Virindi-AC/Dollo/modules/geared_z/README.md

Geared Z module. Originally from Dollo.

Moves the bed by a screw mechanism.

Print:
* 1x gear_one (motor drive gear)
* 4x gear_middle
* 4x gear_worm
* 4x stabilizer
* 4x twist_corner_120 or 8x twist_corner_60
* 4x twist_corner_riser
