Virindi-AC/Dollo/modules/geared_z_spegelius/README.md

Geared Z module. Originally from Spegelius/Dollo.

Moves the bed by a screw mechanism. Similar to original version but with finer gear pitch.

Print:
* 1x gear_one (motor drive gear)
* 4x gear_middle
* 4x gear_worm
* 4x stabilizer
* 4x twist_corner_120 or 8x twist_corner_60
* 4x twist_corner_riser
