Virindi-AC/Dollo/modules/endstops/README.md

Endstop mounting module. Originally from Dollo.
