Virindi-AC/Dollo/modules/spegelius_rack_and_pinion/README.md

Rack and pinion module. Originally from Spegelius/Dollo.

Uses Snappy-derived gear. Motor mount modified to ride on both top and bottom face.
