Virindi-AC/Dollo/modules/virindi_rack_and_pinion/README.md

Rack and pinion module.

Derived from Dollo rack and pinion. Modified for motor set screws.
