Virindi-AC/Dollo/modules/head_e3d/README.md

The original Dollo hotend mount. Contains a single E3Dv6 clone.
