Virindi-AC/Dollo/modules/head_e3d_sensor_fan/README.md

A head that contains an E3Dv6 clone, an 18mm proximity sensor, and a fan. Requires cut out X spacers.
