Virindi-AC/Dollo/include/snappy-reprap/STLs/drive_gear_parts.stl

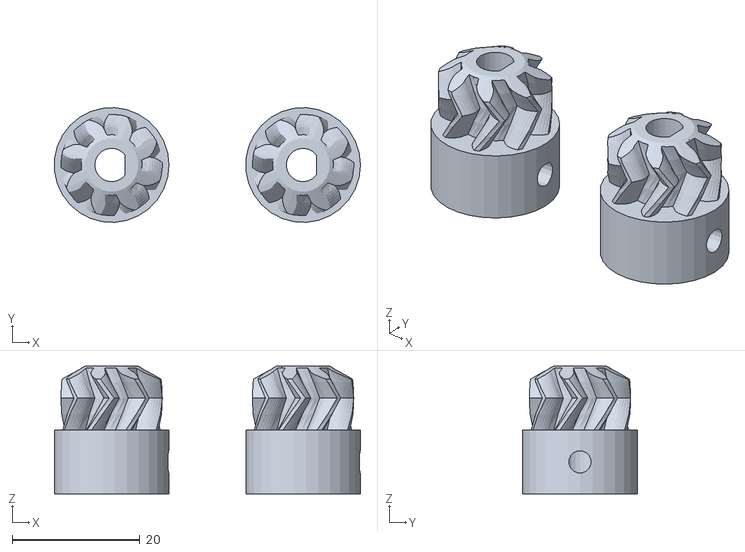
[picture p1: CAD file, 2016-12-03]
include/snappy-reprap/STLs/drive_gear_parts.stl
47.9 x 18.0 x 20.0
