Virindi-AC/Dollo/modules/virindi_rack_and_pinion/small_gear.dxf

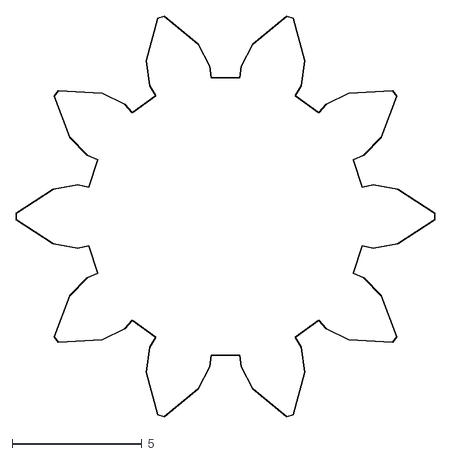
[picture p2: CAD file, 2016-12-03]
modules/virindi_rack_and_pinion/small_gear.dxf
16.2 x 15.5
