Virindi-AC/Dollo/include/snappy-reprap/STLs/ramps_mount_parts.stl

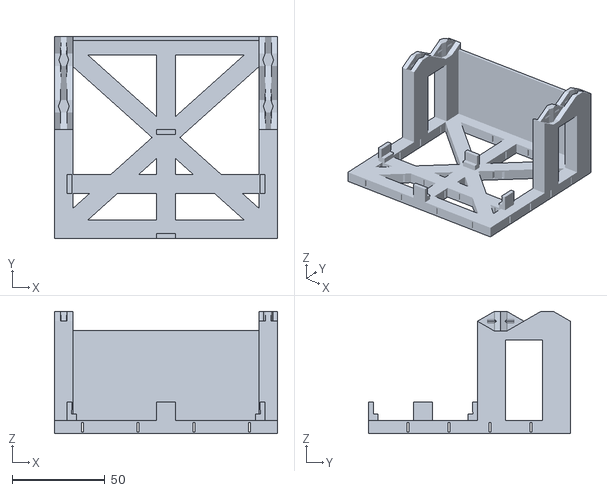
[picture p3: CAD file, 2016-12-03]
include/snappy-reprap/STLs/ramps_mount_parts.stl
120.0 x 108.5 x 65.8
