Virindi-AC/Dollo/modules/virindi_rack_and_pinion/rack.dxf

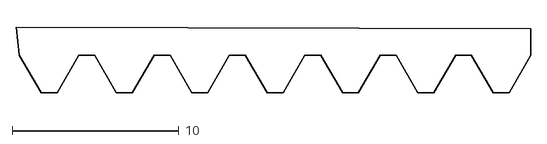
[picture p4: CAD file, 2016-12-03]
modules/virindi_rack_and_pinion/rack.dxf
30.8 x 3.95
