Virindi-AC/Dollo/include/snappy-reprap/STLs/rail_z_endcap_parts.stl

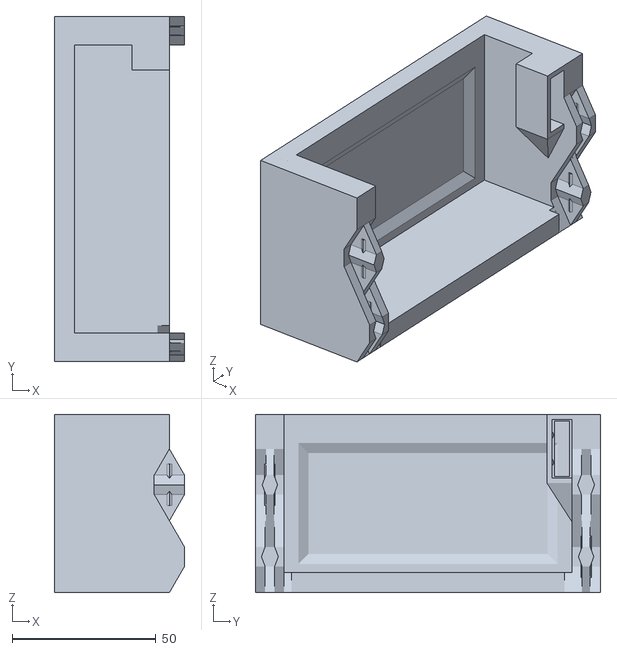
[picture p5: CAD file, 2016-12-03]
include/snappy-reprap/STLs/rail_z_endcap_parts.stl
45.3 x 120.0 x 62.0
