Virindi-AC/Dollo/include/snappy-reprap/STLs/extruder_motor_clip_parts.stl

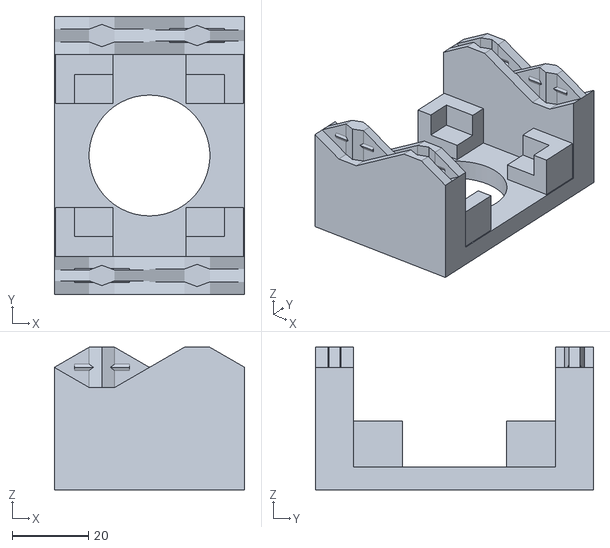
[picture p6: CAD file, 2016-12-03]
include/snappy-reprap/STLs/extruder_motor_clip_parts.stl
50.0 x 73.0 x 37.4
