Virindi-AC/Dollo/include/snappy-reprap/STLs/platform_support_parts.stl

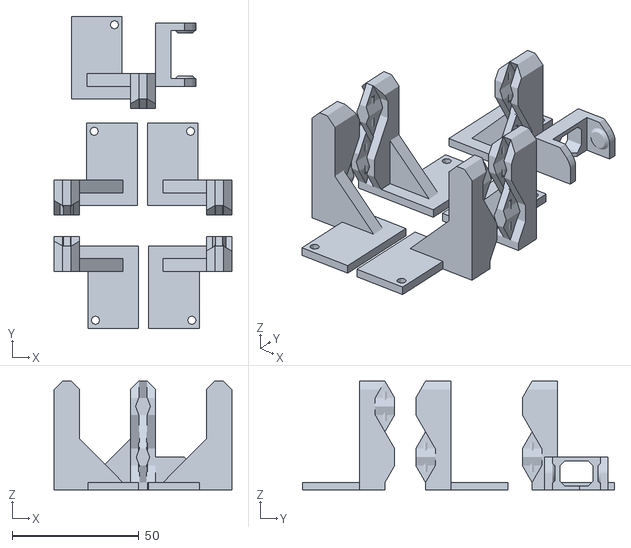
[picture p7: CAD file, 2016-12-03]
include/snappy-reprap/STLs/platform_support_parts.stl
70.0 x 123.0 x 43.0
