Virindi-AC/Dollo/include/snappy-reprap/STLs/xy_joiner_parts.stl

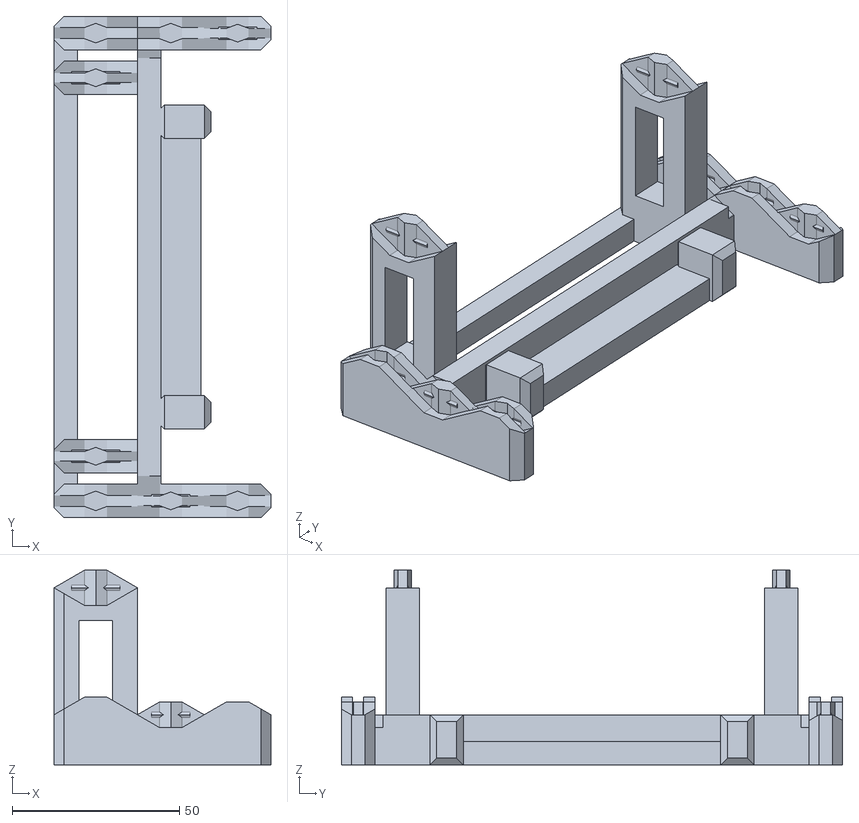
[picture p8: CAD file, 2016-12-03]
include/snappy-reprap/STLs/xy_joiner_parts.stl
65.0 x 150.0 x 58.3
