Virindi-AC/Dollo/include/snappy-reprap/STLs/extruder_idler_parts.stl

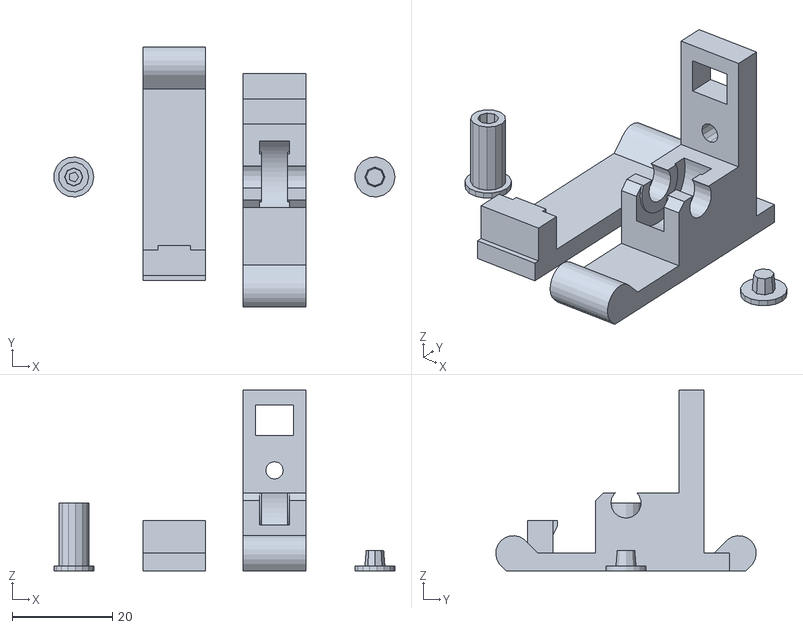
[picture p9: CAD file, 2016-12-03]
include/snappy-reprap/STLs/extruder_idler_parts.stl
67.9 x 51.9 x 36.0
