Virindi-AC/Dollo/include/snappy-reprap/STLs/sled_endcap_parts.stl

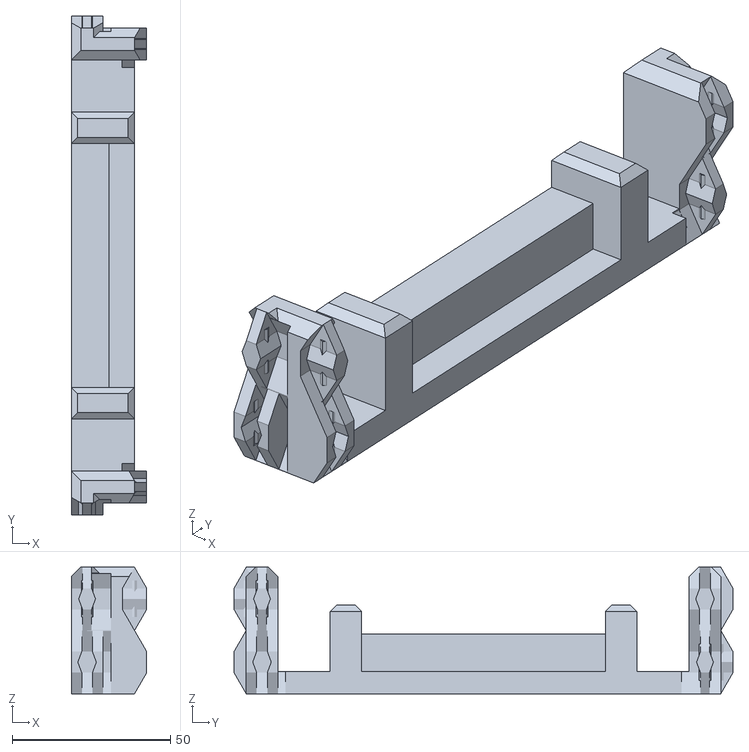
[picture p10: CAD file, 2016-12-03]
include/snappy-reprap/STLs/sled_endcap_parts.stl
23.8 x 157.7 x 40.0
