Virindi-AC/Dollo/include/snappy-reprap/STLs/cable_chain_link_parts.stl

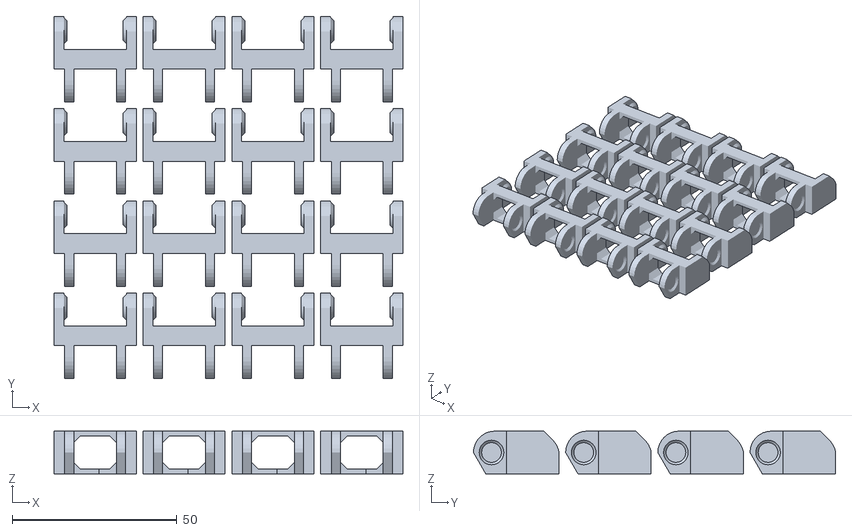
[picture p11: CAD file, 2016-12-03]
include/snappy-reprap/STLs/cable_chain_link_parts.stl
106.0 x 110.0 x 13.0
