Virindi-AC/Dollo/include/snappy-reprap/STLs/lifter_rod_coupler_parts.stl

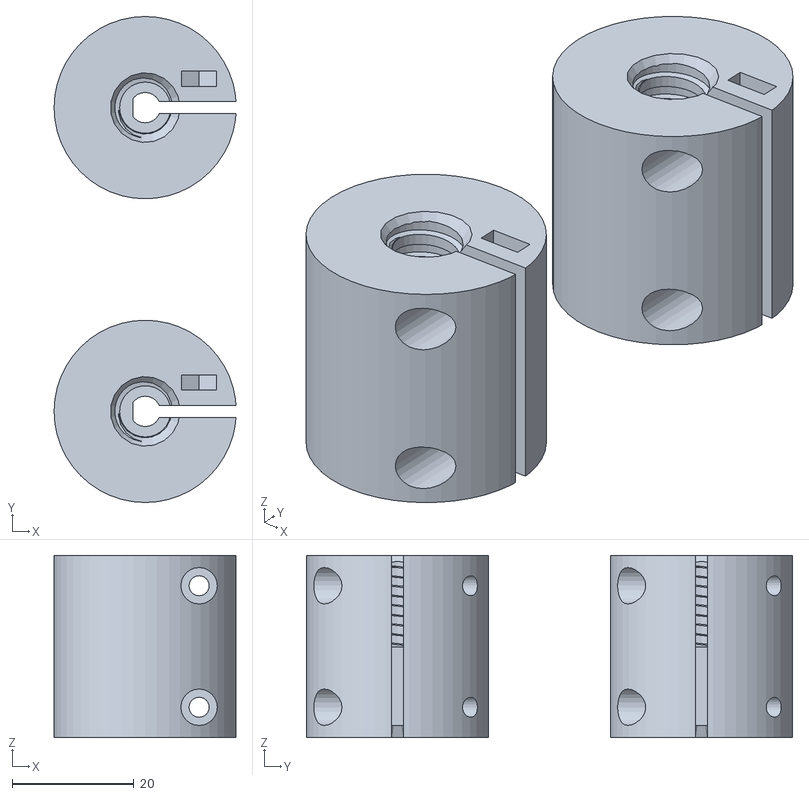
[picture p12: CAD file, 2016-12-03]
include/snappy-reprap/STLs/lifter_rod_coupler_parts.stl
29.9 x 80.0 x 30.0
