Virindi-AC/Dollo/include/snappy-reprap/STLs/spool_holder_parts.stl

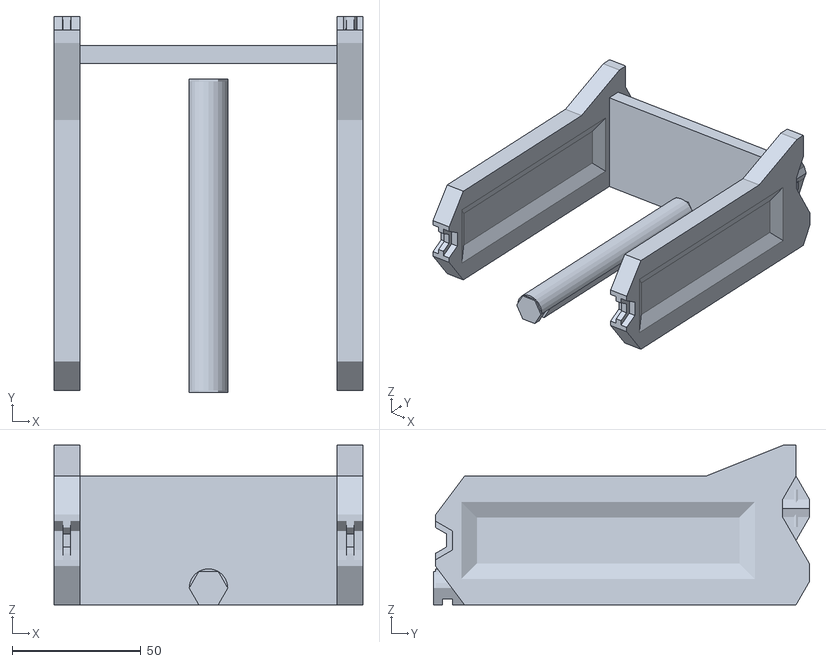
[picture p13: CAD file, 2016-12-03]
include/snappy-reprap/STLs/spool_holder_parts.stl
120.0 x 146.2 x 62.0
