Virindi-AC/Dollo/include/snappy-reprap/STLs/slop_calibrator_parts.stl

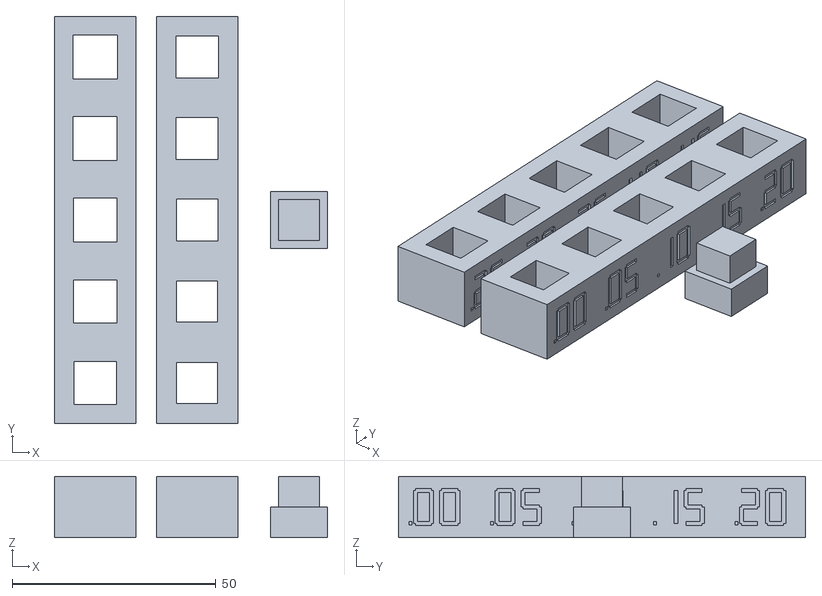
[picture p14: CAD file, 2016-12-03]
include/snappy-reprap/STLs/slop_calibrator_parts.stl
67.0 x 100.0 x 15.0
