Virindi-AC/Dollo/include/snappy-reprap/STLs/cooling_fan_shroud_parts.stl

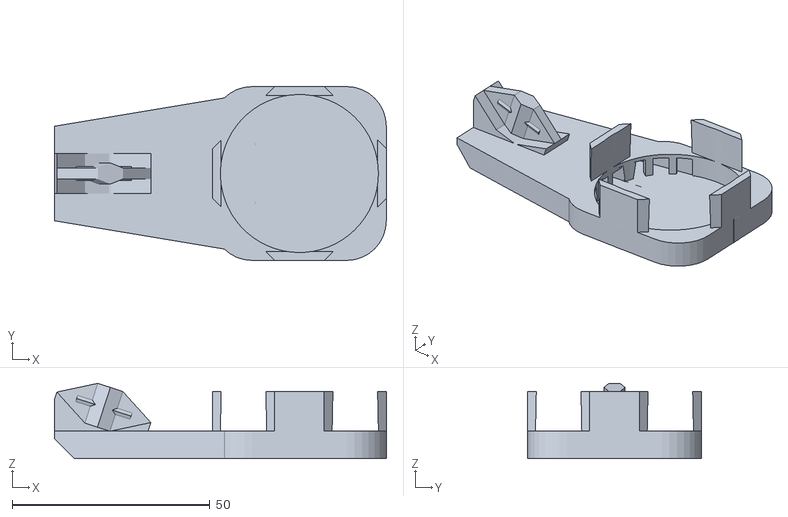
[picture p15: CAD file, 2016-12-03]
include/snappy-reprap/STLs/cooling_fan_shroud_parts.stl
84.0 x 44.1 x 19.1
