Virindi-AC/Dollo/include/snappy-reprap/STLs/jhead_platform_parts.stl

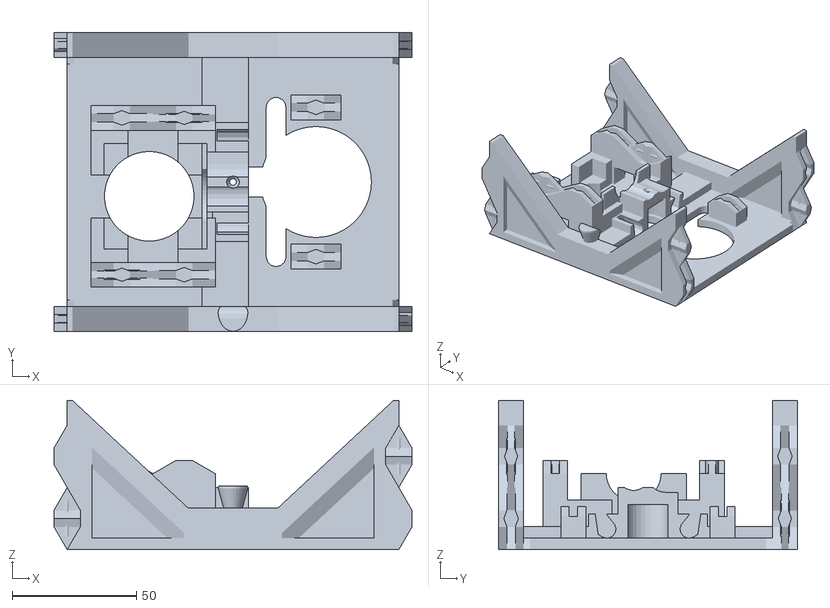
[picture p16: CAD file, 2016-12-03]
include/snappy-reprap/STLs/jhead_platform_parts.stl
143.8 x 120.0 x 60.0
