Virindi-AC/Dollo/include/snappy-reprap/STLs/rail_z_motor_segment_parts.stl

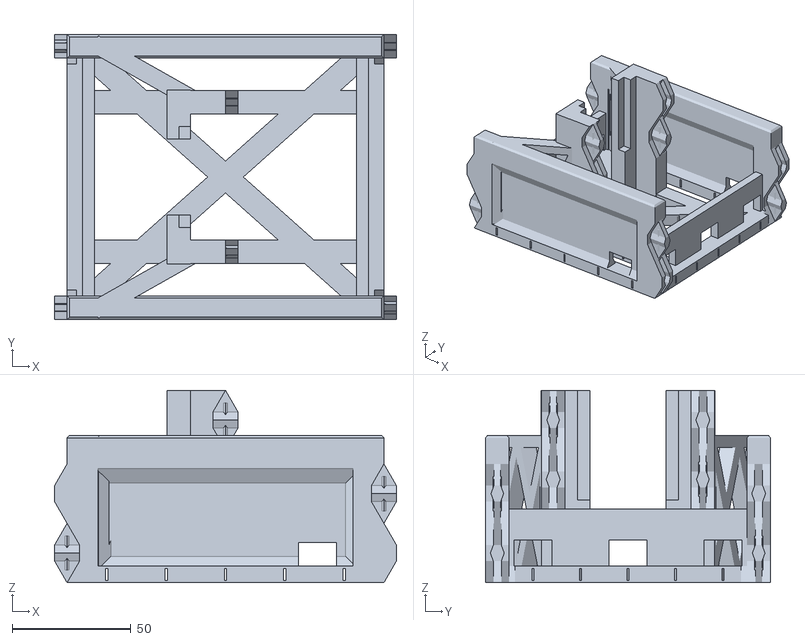
[picture p18: CAD file, 2016-12-03]
include/snappy-reprap/STLs/rail_z_motor_segment_parts.stl
143.9 x 120.0 x 81.0
