Virindi-AC/Dollo/include/snappy-reprap/STLs/extruder_fan_shroud_parts.stl

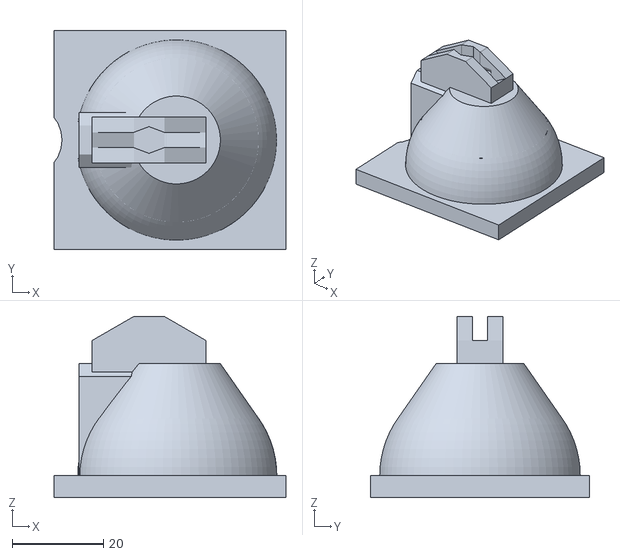
[picture p19: CAD file, 2016-12-03]
include/snappy-reprap/STLs/extruder_fan_shroud_parts.stl
50.8 x 48.0 x 39.7
