Virindi-AC/Dollo/include/snappy-reprap/STLs/rail_xy_motor_segment_parts.stl

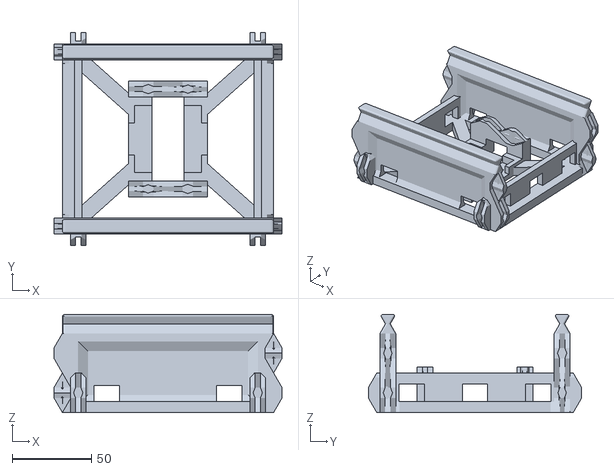
[picture p20: CAD file, 2016-12-03]
include/snappy-reprap/STLs/rail_xy_motor_segment_parts.stl
143.9 x 134.6 x 62.0
