Virindi-AC/Dollo/include/snappy-reprap/STLs/yz_joiner_parts.stl

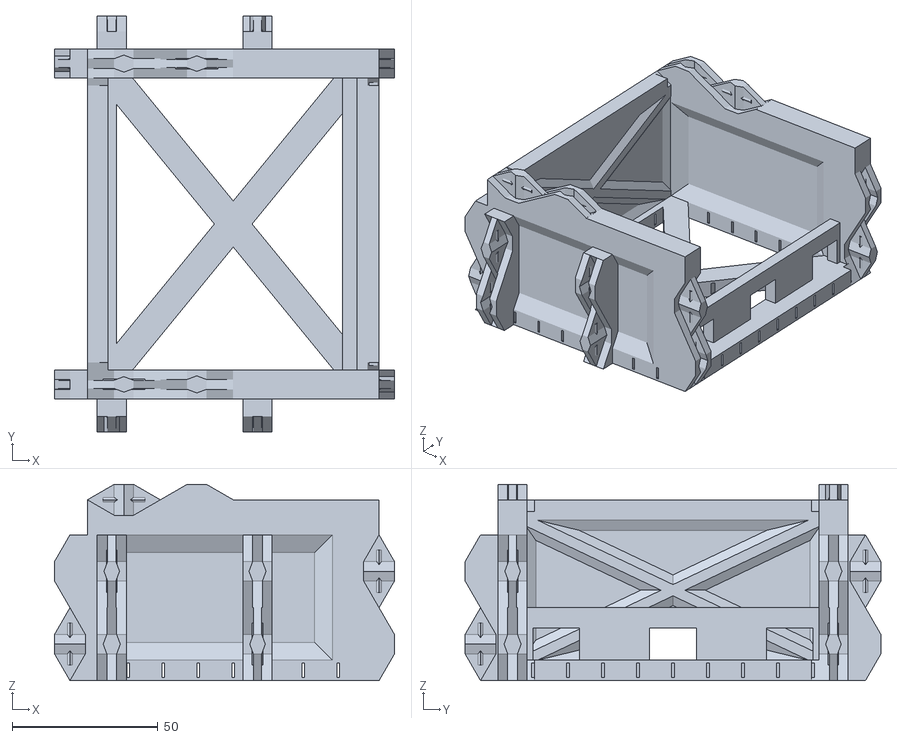
[picture p21: CAD file, 2016-12-03]
include/snappy-reprap/STLs/yz_joiner_parts.stl
116.6 x 142.6 x 67.3
