Virindi-AC/Dollo/include/snappy-reprap/STLs/xy_sled_parts.stl

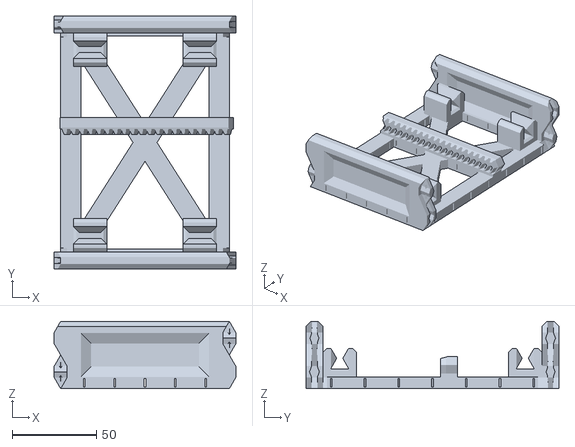
[picture p22: CAD file, 2016-12-03]
include/snappy-reprap/STLs/xy_sled_parts.stl
107.7 x 150.0 x 40.0
