Virindi-AC/Dollo/include/snappy-reprap/STLs/rambo_mount_parts.stl

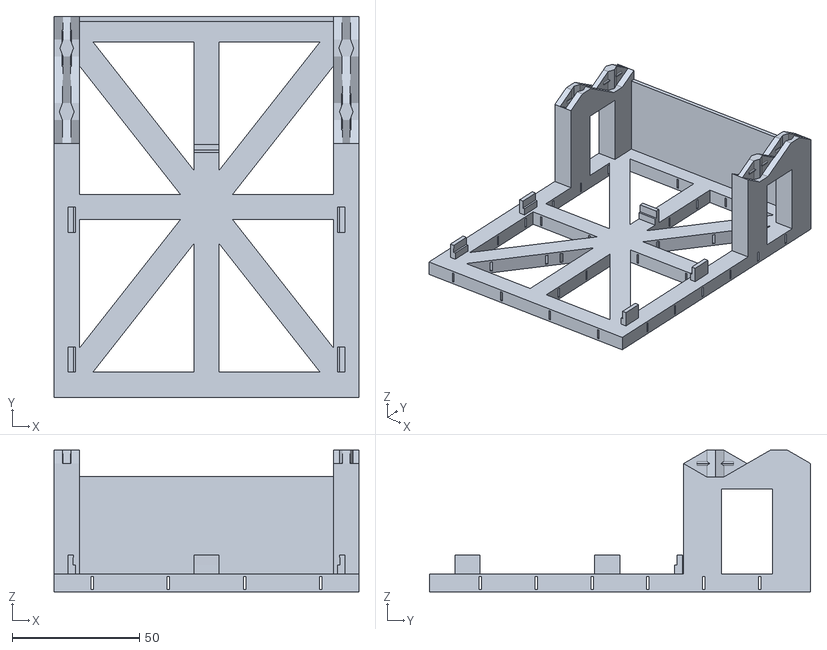
[picture p23: CAD file, 2016-12-03]
include/snappy-reprap/STLs/rambo_mount_parts.stl
120.0 x 150.0 x 55.8
