Virindi-AC/Dollo/include/snappy-reprap/STLs/cable_chain_mount_parts.stl

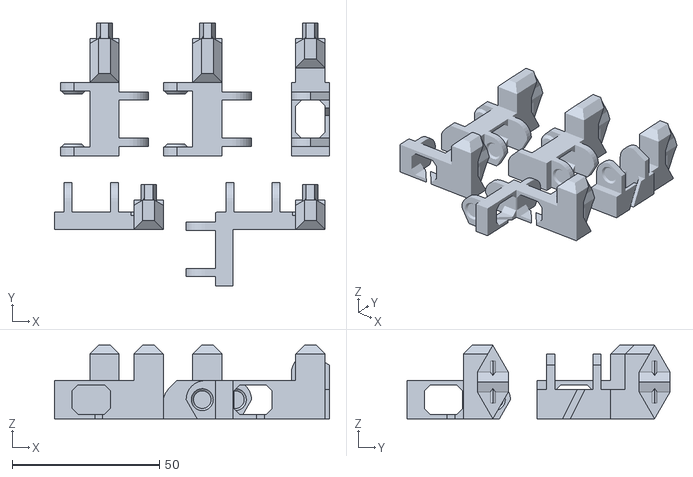
[picture p24: CAD file, 2016-12-03]
include/snappy-reprap/STLs/cable_chain_mount_parts.stl
93.5 x 89.5 x 25.0
