Virindi-AC/Dollo/include/snappy-reprap/STLs/z_sled_parts.stl

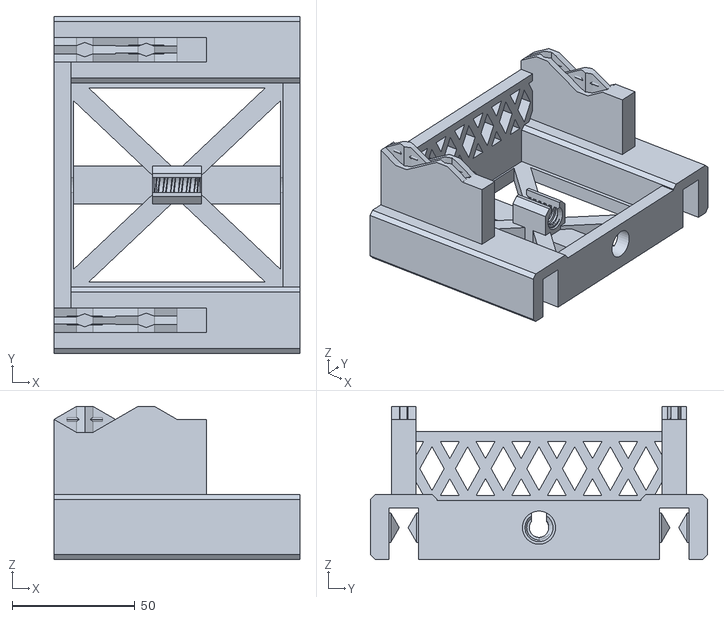
[picture p25: CAD file, 2016-12-03]
include/snappy-reprap/STLs/z_sled_parts.stl
100.0 x 137.0 x 62.3
