Virindi-AC/Dollo/include/snappy-reprap/STLs/extruder_fan_clip_parts.stl

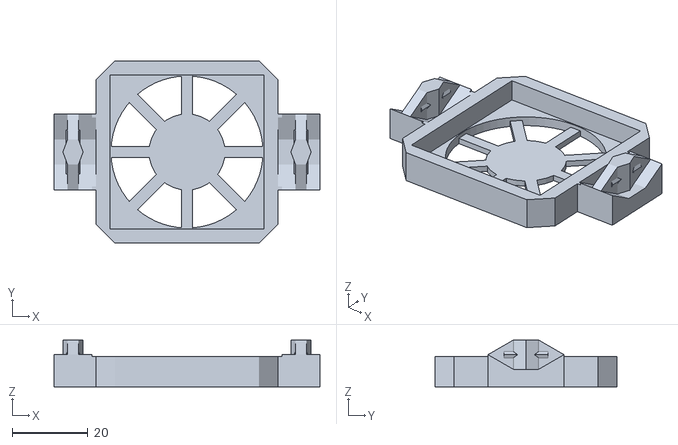
[picture p26: CAD file, 2016-12-03]
include/snappy-reprap/STLs/extruder_fan_clip_parts.stl
70.0 x 48.0 x 12.3
