Virindi-AC/Dollo/include/snappy-reprap/STLs/motor_mount_plate_parts.stl

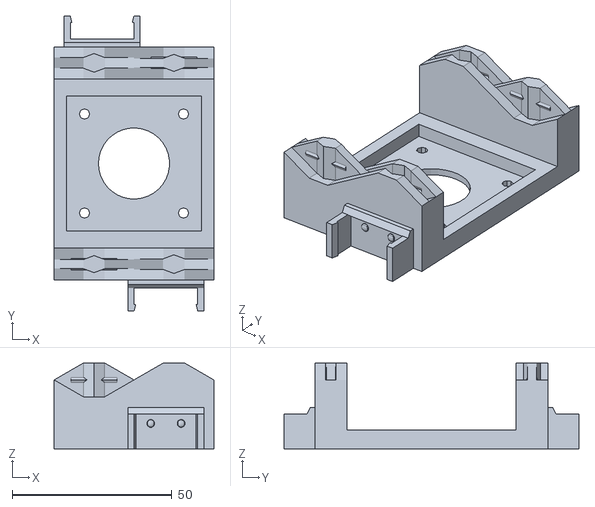
[picture p27: CAD file, 2016-12-03]
include/snappy-reprap/STLs/motor_mount_plate_parts.stl
50.0 x 92.3 x 26.9
