Virindi-AC/Dollo/include/snappy-reprap/STLs/support_leg_parts.stl

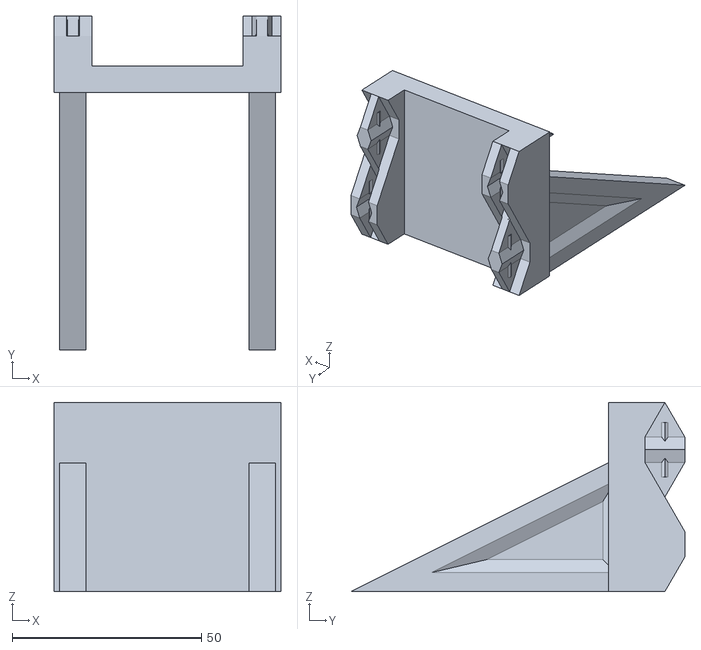
[picture p28: CAD file, 2016-12-03]
include/snappy-reprap/STLs/support_leg_parts.stl
60.0 x 88.2 x 50.0
