Virindi-AC/Dollo/include/conf/sturdy_E3D_config.scad

//
// Mendel90
//
// GNU GPL v2
// nop.head@gmail.com
// hydraraptor.blogspot.com
//
// Configuration file
//
echo("Sturdy E3D:");

Z_bearings = LM6UU;
Y_bearings = LM6UU;
X_bearings = LM6UU;

X_motor = NEMA17;
Y_motor = NEMA17;
Z_motor = NEMA17;

hot_end = e3dv6;

X_travel = 110;
Y_travel = 82;
Z_travel = 169;

bed_depth = 82;
bed_width = 110;
bed_pillars = M3x20_pillar;
bed_glass = glass2;
bed_thickness = pcb_thickness + sheet_thickness(bed_glass);    // PCB heater plus glass sheet
bed_holes = [209, 209];

base = MDF19;
base_corners = 0;

frame = MDF19;
frame_corners = 0;
frame_nuts = false;

case_fan = fan80x38;
psu = ALPINE500;
//psu = KY240W;
controller = Melzi;
//controller = Sanguinololu;
spool = spool_300x85;
bottom_limit_switch = false;
top_limit_switch = true;

single_piece_frame = true;
stays_from_window = false;

Y_carriage = DiBond;

pulley_type = GT2x20_metal_pulley;
X_belt = GT2x6;
Y_belt = GT2x6;

motor_shaft = 5;
Z_screw_dia = 12.7;            // Studding for Z axis

Y_carriage_depth = bed_holes[1] + 8;
Y_carriage_width = bed_holes[0] + 8;

Z_nut_radius = 11.2;
Z_nut_depth = 44.5;//11.25;
Z_nut = M8_nut;

//
// Default screw use where size doesn't matter
//
cap_screw = M3_cap_screw;
hex_screw = M3_hex_screw;
//
// Screw for the frame and base
//
frame_soft_screw = No6_screw;               // Used when sheet material is soft, e.g. wood
frame_thin_screw = M3_cap_screw;            // Used with nuts when sheets are thin
frame_thick_screw = M3_pan_screw;           // Used with tapped holes when sheets are thick and hard, e.g. plastic or metal
//
// Feature sizes
//
default_wall = 4;
thick_wall = 4;
