Virindi-AC/Dollo/include/conf/machine.scad

include <sturdy_E3D_config.scad>
