Virindi-AC/Dollo/modules/head_e3d_sensor_fan/x_spacer_cut.scad

include <../../globals.scad>;
include <../../include.scad>;
use <long_bow_tie_cut.scad>

tail_depth = 55;
tail_depth_2 = -10;
thickness = 21;
module y_mount_added(){
	translate([0,-15+6-3.5,51/2]) cube([30,thickness,51], center=true);
    
    translate([-8,-12.5+thickness/2,-55+tail_depth]) scale([dovetail_male_width_scale, dovetail_male_height_scale, 0.9]) male_dovetail(height=15);
	translate([8,-12.5+thickness/2,-55+tail_depth]) scale([dovetail_male_width_scale, dovetail_male_height_scale, 0.9]) male_dovetail(height=15);
    

}

module y_mount_taken(){
	translate([0,-thickness/2-12.5,15]) rotate([0,45,0]) tie_end();
    
	rotate([180,0,0]) translate([-8,12.5-thickness/2,-55+tail_depth_2]) scale([.9,.9,.9]) male_dovetail(height=30);
	rotate([180,0,0]) translate([8,12.5-thickness/2,-55+tail_depth_2]) scale([.9,.9,.9]) male_dovetail(height=30);
translate([-15,-45,0]) wrap(3);
}
/*
rotate([90,0,0]) difference(){
	translate([0,-thickness/2-12.5,15]) bow_support();
	translate([0,-thickness/2-12.5,25]) cube([50,10,20], center=true);
	translate([0,-thickness/2-12.5,0]) cube([31,10,20], center=true);
}
*/

module x_spacer()
{
rotate([90,0,0]) 
    difference(){
	y_mount_added();
	y_mount_taken();
        
    translate([0,0,240-4])
    rotate([0,-40,0])
    cube([300,300,300],center=true);
    
    translate([0,0,150+47])
    cube([300,300,300],center=true);
}
}



translate([20,0,0])
x_spacer();

translate([-20,0,0])
mirror([1,0,0]) x_spacer();

//translate([-28,-38,0])
//cut_tie();
