Virindi-AC/Dollo/modules/printed_bed_base/arm.scad

use <bed_carriage.scad>

height = 12;
translate([-50,-50]) arm();
