Virindi-AC/Dollo/modules/printed_bed_base/center_motor.scad

use <bed_carriage.scad>

height = 12;
translate([0,0,0]) center_motor();
