Virindi-AC/Dollo/modules/printed_bed_base/corner_arm.scad

use <bed_carriage.scad>

height = 12;
translate([-60,-70]) rotate([0,0,315]) corner_arm();
