Virindi-AC/Dollo/modules/printed_bed_base/edge_arm_left.scad

use <bed_carriage.scad>

height = 12;
translate([60,10, height]) rotate([0,180,90]) edge_arm();
