Virindi-AC/Dollo/modules/printed_bed_base/edge_arm_right.scad

use <bed_carriage.scad>

height = 12;
translate([60,-205, height]) mirror([0,1,0]) rotate([0,180,90]) edge_arm();
