Virindi-AC/Dollo/modules/printed_bed_base/motor_arm.scad

use <bed_carriage.scad>

height = 12;
translate([-40,-120,0]) motor_arm();
