Virindi-AC/Dollo/modules/printed_structural/long_bow_tie_motorspacer.scad

length = 15.5;
tilt_level = 1.1;
scaling_x = .95;
scaling_y = 1;
scaling_z = 1;
include <../../include.scad>;
include <../../globals.scad>;

obj_leg= 12;
module bow_tie_master(){
	union(){
		mirror([0,1,0]){
			scale([1.08,1,1]) male_dovetail(height=length);
		}
			male_dovetail(height=length);		
	}
}

intersection(){
    scale([scaling_x,scaling_y,scaling_z])	rotate([90,0,0]) bow_tie_master();
    rotate([90,0,0]) cylinder(r=5.7, h=200);
}
