Virindi-AC/Dollo/modules/geared_z_spegelius/gear_middle.scad

use <gears.scad>

middle_gear();
