Virindi-AC/Dollo/modules/geared_z_spegelius/gear_one.scad

use <gears.scad>

gear_one();
