Virindi-AC/Dollo/modules/geared_z_spegelius/gear_worm.scad

use <gears.scad>

gear_large();
