Virindi-AC/Dollo/modules/geared_z_spegelius/twist_corner.scad

include <../../include.scad>;
include <../../globals.scad>;
use <gears.scad>;

///////////////////// FOCUS ON THIS NOW //////////////////////////////
tooth_depth = (sqrt(18)/2)+2;
twisted_depth = 2;
//units = 4; //Multiple of 2
r =37;
mirror = true;
double = false; //this will make the piece twist in both directions. only works if you have a high pitch screw

gearOne = -16.5;
gear_reverse = -10;
gearLarge = -32.6+(gearOne/2);

resolution = 60;
///////////////////// FOCUS ON THIS NOW //////////////////////////////

// side rounded hollows and inside dovetail tracks
module wrap(units){
    translate([-16.5,30+4,-32]) rotate([0,90,-90]) male_dovetail();
    translate([-32,30+4,-16.5]) rotate([-90,180,0])  male_dovetail();
    
    rotate([90,0,0]) translate([-35,-1,-25*units]) cylinder(h=35*units, r=8);
    mirror([1,0,-1]) rotate([90,0,0]) translate([-35,-1,-25*units]) cylinder(h=35*units, r=8);
}

module arm_movement(units){
	difference(){
		//part im trying to make
        difference(){
            translate([-95+tooth_depth,-95+tooth_depth,15*units]) rotate([0,0,45]) cube([45,45,((units+1)*30)-.25], center=true);
            translate([-105+(-15/2),-105+(-15/2),30]) cube([45,45,30*2*units], center=true);
        }
        //twist
	
        for (extrude=[0:units+3]){
            translate([0+(gearLarge+(gearLarge/2))+tooth_depth,0+(gearLarge+(gearLarge/2))+tooth_depth,extrude*20]) color([0,1,0]) rotate([0,0,(360/22)*1.75]) twist_large_extrude($fn=resolution);
            translate([21.5-95,21.5-95,extrude*30-45-5]) rotate([90,0,90]) wrap(units=units);
        }

	}
}

module finished(units){
	intersection(){
		translate([95,95,0]) arm_movement(units=units);
		hull(){
			translate([tooth_depth+25.5,0,0]) cylinder(h=(units+2)*30, r=2);
			translate([0,tooth_depth+25.5,0]) cylinder(h=(units+2)*30, r=2);
			
			translate([-(tooth_depth+26),1,0]) cylinder(h=(units+2)*30, r=2);
			translate([1,-(tooth_depth+26),0]) cylinder(h=(units+2)*30, r=2);
		}
	}
}
module base(units){
	intersection(){
		translate([0,0,0]) rotate([0,0,45]) finished(units=units);
		//translate([-50,-50,0]) cube([100,100,units*40]);
	}
}

module top_dove(units) {
    intersection() {
        scale([dovetail_male_width_scale, 1, dovetail_male_height_scale]) rotate ([90,0,0]) intersection() {
            intersection() {
                male_dovetail(height=11.7);
                translate([-6,0,0]) cube([10,4.6,25]);
            }
            translate([0,-0.3, 0]) cylinder(r=5.7, h=20);
        }
        translate([-5,-6,-4.2]) rotate([0,90,0]) cylinder(r=10, h=20);
    }
}
//translate([50,50,0]) top_dove(); //testing

module twist_corner(units = 4){
    difference(){
        intersection(){
            rotate([0,-2,0]) base(units=units);
            translate([-50,-50,1.38]) cube([100,100,units*30]);
        }
        translate([0,0,1]) union(){
            translate([11,15,0]) rotate([90,0,0]) male_dovetail(height=25);
            translate([-11,15,0]) rotate([90,0,0]) male_dovetail(height=25);
        }
    }

    translate([-2 * (units/2),0,0]) difference(){
        union(){
            translate([11,14.2,30*units+1.1]) top_dove(units=units);
            translate([-11,14.2,30*units+1.1]) top_dove(units=units);
        }
            translate([0,-33,0]) rotate([0,0,45]) cube([30,30,units*45]);
        }
}

// do it
//twist_corner(units = );
