Virindi-AC/Dollo/modules/geared_z_spegelius/twist_corner_120.scad

use <twist_corner.scad>

twist_corner(units = 4);
