Virindi-AC/Dollo/modules/geared_z_spegelius/twist_corner_60.scad

use <twist_corner.scad>

twist_corner(units = 2);
