Virindi-AC/Dollo/modules/printed_bed_base/boltholder.scad

use <bed_carriage.scad>

height = 12;
translate([70, -100]) boltholder();
