Virindi-AC/Dollo/modules/printed_bed_base/boltholder_center.scad

use <bed_carriage.scad>

height = 12;
translate([90, -100]) boltholder_center();
