Virindi-AC/Dollo/modules/printed_bed_base/center.scad

use <bed_carriage.scad>

height = 12;
center();
