Virindi-AC/Dollo/modules/printed_structural/bow_tie.scad

smoothing = 100;
length = 13;
tilt_level = 1.1;
scaling_x = .9;
scaling_y = 1;
scaling_z = 1;
include <../../include.scad>;
include <../../globals.scad>;

obj_leg= 12;
$fn = smoothing;
module bow_tie_master(){
	union(){
		mirror([0,1,0]) 		intersection(){
			intersection(){
				rotate([0,-45,0]) cube([obj_leg,obj_leg,obj_leg]);
				translate([-obj_leg/2,(obj_leg/2)-tilt_level,-5]) rotate([45,0,0]) cube([obj_leg,obj_leg,obj_leg*2]);
				#translate([0,length/4,length*.5]) rotate([45,0,0]) sphere(d=length*tilt_level);
			}
			male_dovetail(height=length);
		}
		
		intersection(){
			intersection(){
				rotate([0,-45,0]) cube([obj_leg,obj_leg,obj_leg]);
				translate([-obj_leg/2,(obj_leg/2)-tilt_level,-5]) rotate([45,0,0]) cube([obj_leg,obj_leg,obj_leg*2]);
				#translate([0,length/4,length*.5]) rotate([45,0,0]) sphere(d=length*tilt_level);
			}
			male_dovetail(height=length);
		}
		
	}
}
module bow_holes() {
	//translate([-10,-2.5,-2.5]) rotate([0,90,0]) #cylinder(h=50, d=1.5);
	//translate([-10,2.5,-2.5]) rotate([0,90,0]) #cylinder(h=50, d=1.5);
}

module finished(){
	rotate([0,45*0,0]){
		difference(){
			rotate([0,180,0]) bow_tie_master();
			bow_holes();
            translate([0,0,-25]) cylinder(d=2.5, h=50);
		}
	}
}

scale([scaling_x,scaling_y,scaling_z]) finished();
