Virindi-AC/Dollo/modules/printed_structural/extension_120.scad

use <extension.scad>

extension_finished(units=4);
