Virindi-AC/Dollo/modules/printed_structural/extension_120_side.scad

use <extension.scad>

rotate([-90,0,0])
extension_finished(units=4,support=false);
