Virindi-AC/Dollo/modules/printed_structural/extension_30.scad

use <extension.scad>

extension_finished(units=1);
