Virindi-AC/Dollo/modules/v4x/extension_10.scad

use <../printed_structural/extension.scad>

extension_finished(units=(10-0.9)/30, support=false);
