Virindi-AC/Dollo/modules/v4x/extension_250.scad

use <../printed_structural/extension.scad>

extension_finished(units=250/30, support=true);
