Virindi-AC/Dollo/modules/virindi_rack_and_pinion/rack.scad

include <../../include.scad>;
include <../../globals.scad>;


//globals

obj_height = 40;
//units = 10; //only even numbers
tail_depth = 8;
tie_scale_x = 1;
tie_scale_y = 1;
tie_scale_z = 1;
gear_cut_depth = 4;
gear_cut_from_center = 9.25;
rounding_diameter = 4;

resolution = 10;

//good things
module rounded_cube(width,depth,height){
    hull(){
        translate([width/2-rounding_diameter/2,depth/2-rounding_diameter/2,height/2-rounding_diameter/2]) sphere(d=rounding_diameter);
        translate([width/2-(rounding_diameter/2),depth/2-(rounding_diameter/2),-height/2+(rounding_diameter/2)]) sphere(d=rounding_diameter);
        translate([-width/2+rounding_diameter/2,depth/2-rounding_diameter/2,height/2-rounding_diameter/2]) sphere(d=rounding_diameter);
        translate([-width/2+(rounding_diameter/2),depth/2-(rounding_diameter/2),-height/2+(rounding_diameter/2)]) sphere(d=rounding_diameter);
        
        translate([width/2-rounding_diameter/2,-depth/2+rounding_diameter/2,height/2-rounding_diameter/2]) sphere(d=rounding_diameter);
        translate([width/2-(rounding_diameter/2),-depth/2+(rounding_diameter/2),-height/2+(rounding_diameter/2)]) sphere(d=rounding_diameter);
        translate([-width/2+rounding_diameter/2,-depth/2+rounding_diameter/2,height/2-rounding_diameter/2]) sphere(d=rounding_diameter);
        translate([-width/2+(rounding_diameter/2),-depth/2+(rounding_diameter/2),-height/2+(rounding_diameter/2)]) sphere(d=rounding_diameter);
    }
}  

module tie_taken(){
		difference(){
			translate([0,tail_depth,0]) rotate([0,90,180]) scale([tie_scale_x,tie_scale_z,tie_scale_y])  male_dovetail(height=30);
		}
}


//herring bone style rack made from inkscape and OpenScad
module rackObject(units=10) {

    module rackHalf(){
        intersection() {
            union() {
                rotate(a=[0,-25,0]) {
                    linear_extrude(height = obj_height*5, center = true, convexity = 10)
                    import (file = "rack.dxf", layer = "Layer_1");
                }
            }
			translate([0, 0, obj_height/4*-1]) cube(center = true, [31, 50, obj_height/2]);
        }
    }
    module rackFull(){
        intersection() {
            union() {
                mirror([0,0,1]) rackHalf();
                rackHalf();
            }
            union() {
                cube(center = true, [20, 30, obj_height-8]);

            }
        }
    }

    for(rack_length=[-units:5]){
        translate([rack_length*20,0,0]) {
					intersection(){
						rackFull();
						scale([1,.25,1]) translate([0,5,0]) rotate([0,90,0]) cylinder(r=15, h=40, center=true);
					}
		}
	}

	for(rack_length=[-units:1]){
		difference(){
			translate([30*rack_length+15,6,0]) cube([30,8,40], center=true);
		}
	}
}

module rack(units=10)
{
    difference(){
    intersection(){
    //translate([0,0,-10]) cube([20,20,20]);
        intersection(){
            rotate([-90,0,0]) translate([-10-((units-2)*15),0,0]) translate([30,0,0]) rounded_cube(30*units+10,20,40,$fn=resolution);
            union(){
                rotate([-90,0,0]) intersection(){
                    difference(){
                        rackObject();
                        for(rack_length=[-units:1]){
                            translate([30*rack_length+30,2,0]) tie_taken();
                        }
                    }

                    difference(){
                        union(){
                            translate([30,0,0]) rounded_cube(30*units,20,40,$fn=50);
                            translate([-12.5-((units-2)*15),-5,0]) rotate([0,25,0]) cube([30,30,30]);
                            mirror([0,0,1]) translate([-12.5-((units-2)*15),-5,0]) rotate([0,25,0]) cube([30,30,30]);
                        }
                        union(){
                            translate([47.5,-5,0]) rotate([0,25,0]) cube([units*30,30,units*30]);
                            mirror([0,0,1]) translate([47.5,-5,0]) rotate([0,25,0]) cube([units*30,30,units*30]);
                        }
                    }
                //intersection
                }
            //union
            }
        //intersection
        }
    //intersection
    }

    translate([0,10+gear_cut_from_center,25-gear_cut_depth])
    cube([30*units+1,20,50],center=true);
    }
}

rack();
