Virindi-AC/Dollo/modules/virindi_rack_and_pinion/rack_x.scad

use <rack.scad>

rack(units=8);
