Virindi-AC/Dollo/(list of files, cad)

Other CAD files:
include/snappy-reprap/STLs/rail_segment_parts.stl
modules/virindi_rack_and_pinion/motor_mount_small.scad
modules/geared_z_spegelius/gears.scad
modules/head_e3d/hot_end_mount.scad
modules/head_e3d/x_spacer.scad
modules/printed_structural/corner_4.scad
modules/printed_structural/long_bow_tie.scad
modules/v4x/pulley_tooth.scad
include/conf/colors.scad
include/conf/config.scad
include/conf/dibond_E3D_config.scad
include/conf/dibond_config.scad
include/conf/huxley_config.scad
include/conf/mendel_config.scad
include/conf/sturdy_config.scad
include/conf/utils.scad
include/conf/vitamins.scad
include/publicDomainGearV1.1.scad
include/snappy-reprap/GDMUtils.scad
include/snappy-reprap/NEMA.scad
include/snappy-reprap/STLs/lifter_lock_nut_parts.stl
include/snappy-reprap/acme_screw.scad
include/snappy-reprap/cable_chain.scad
include/snappy-reprap/cable_chain_link_parts.scad
include/snappy-reprap/cable_chain_mount_parts.scad
include/snappy-reprap/cooling_fan_shroud_parts.scad
include/snappy-reprap/drive_gear_parts.scad
include/snappy-reprap/extruder_fan_clip_parts.scad
include/snappy-reprap/extruder_fan_shroud_parts.scad
include/snappy-reprap/extruder_idler_parts.scad
include/snappy-reprap/extruder_motor_clip_parts.scad
include/snappy-reprap/full_assembly.scad
include/snappy-reprap/jhead_platform_parts.scad
include/snappy-reprap/joiners.scad
include/snappy-reprap/lifter_lock_nut_parts.scad
include/snappy-reprap/lifter_rod_coupler_parts.scad
include/snappy-reprap/motor_mount_plate_parts.scad
include/snappy-reprap/platform_support_parts.scad
include/snappy-reprap/publicDomainGearV1.1.scad
include/snappy-reprap/rail_segment_parts.scad
include/snappy-reprap/rail_xy_motor_segment_parts.scad
include/snappy-reprap/rail_y_endcap_parts.scad
include/snappy-reprap/rail_z_endcap_parts.scad
include/snappy-reprap/rail_z_motor_segment_parts.scad
include/snappy-reprap/rambo_mount_parts.scad
include/snappy-reprap/ramps_mount_parts.scad
include/snappy-reprap/sled_endcap_parts.scad
include/snappy-reprap/sliders.scad
include/snappy-reprap/slop_calibrator_parts.scad
include/snappy-reprap/spool_holder_parts.scad
include/snappy-reprap/support_leg_parts.scad
include/snappy-reprap/vitamins.scad
include/snappy-reprap/wiring.scad
include/snappy-reprap/xy_joiner_parts.scad
include/snappy-reprap/xy_sled_parts.scad
include/snappy-reprap/yz_joiner_parts.scad
include/snappy-reprap/z_sled_parts.scad
include/utils/bom.scad
include/utils/cables.scad
include/utils/polyholes.scad
include/utils/shields.scad
include/utils/teardrops.scad
include/vitamins/ball-bearings.scad
include/vitamins/bars.scad
include/vitamins/belts.scad
include/vitamins/bulldog.scad
include/vitamins/cable_strip.scad
include/vitamins/components.scad
include/vitamins/d-connectors.scad
include/vitamins/electronics.scad
include/vitamins/extruders.scad
include/vitamins/fans.scad
include/vitamins/hot_ends.scad
include/vitamins/jhead_hot_end.scad
include/vitamins/light_strips.scad
include/vitamins/linear-bearings.scad
include/vitamins/m90_hot_end.scad
include/vitamins/microswitch.scad
include/vitamins/nuts.scad
include/vitamins/o_rings.scad
include/vitamins/pillars.scad
include/vitamins/pullies.scad
include/vitamins/raspberry_pi.scad
include/vitamins/screws.scad
include/vitamins/spools.scad
include/vitamins/springs.scad
include/vitamins/stepper-motors.scad
include/vitamins/stoffel_hot_end.scad
include/vitamins/terminals.scad
include/vitamins/tubing.scad
include/vitamins/washers.scad
include/vitamins/ziptie.scad
modules/geared_z/stabilizer.scad
modules/geared_z_spegelius/stabilizer.scad
