Virindi-AC/Dollo/modules/printed_bed_base/README.md

Printed bed base module. Originally from Dollo.

To print:
* 1x center.scad
* 1x center_motor.scad
* 4x arm.scad
* 4x corner_arm.scad
* 4x edge_arm_left.scad
* 4x edge_arm_right.scad
* 4x motor_arm.scad
* ?? boltholder.scad
* ?? boltholder_center.scad
