Virindi-AC/Dollo/modules/printed_structural/README.md

Printed structural module. Originally from Dollo.
