Virindi-AC/Dollo/include/snappy-reprap/docs/assembly/index.html

# Snappy RepRap Assembly Instructions

## XY Motor Assembly

1. Press-fit a drive gear onto the shaft of a stepper motor, making sure to align the flat of the shaft with the flat of the shaft hole. Repeat this with the other drive gear and another stepper.

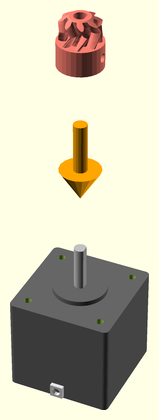
[picture p29: include/snappy-reprap/docs/assembly/xy_motor_assembly_before.png]
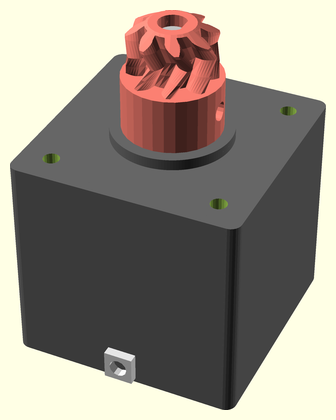
[picture p30: include/snappy-reprap/docs/assembly/xy_motor_assembly_after.png]
 |  | 

## Motor Mount Assembly

2. Attach a limit micro-switch (with wiring) to one of the side clips, with the lever end towards the center. Do this again for a second switch and mount plate.

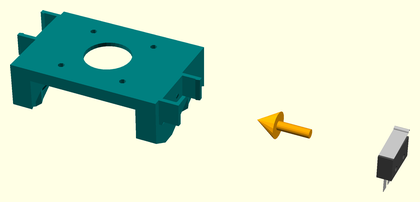
[picture p31: include/snappy-reprap/docs/assembly/motor_mount_assembly_before.png]
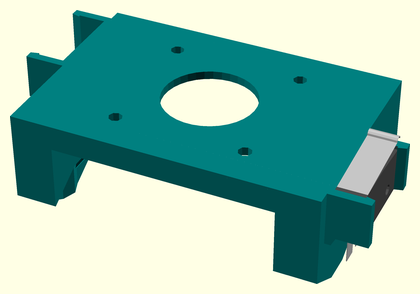
[picture p32: include/snappy-reprap/docs/assembly/motor_mount_assembly_after.png]
 |  | 

## Y Motor Segment Assembly

3. Seat the stepper motor with drive gear in the X/Y motor rail segment. Clamp it into place with a motor mount plate with micro-switch. Route the wiring out a side wiring access hole opposite the limit switch.

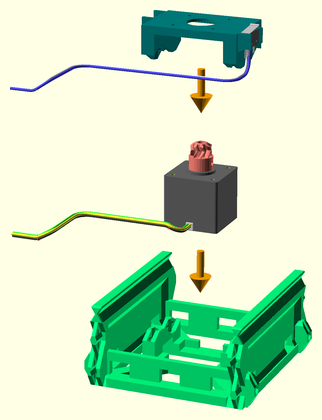
[picture p33: include/snappy-reprap/docs/assembly/y_motor_segment_assembly_before.png]
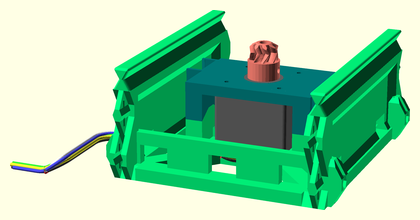
[picture p34: include/snappy-reprap/docs/assembly/y_motor_segment_assembly_after.png]
 |  | 

## Y Axis Assembly

### Step 1

  - Join a rail segment to each end of another motor rail assembly.

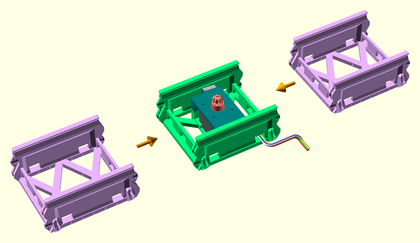
[picture p35: include/snappy-reprap/docs/assembly/y_axis_assembly_1_before.png]
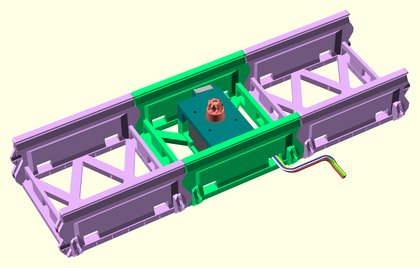
[picture p36: include/snappy-reprap/docs/assembly/y_axis_assembly_1_after.png]
 |  | 

### Step 2

  - Join opposing platform supports to either side of the sled endcap. Point the tabs toward the side with the joiners.

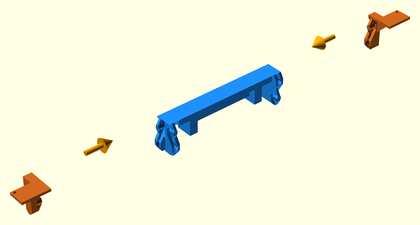
[picture p37: include/snappy-reprap/docs/assembly/y_axis_assembly_2_before.png]
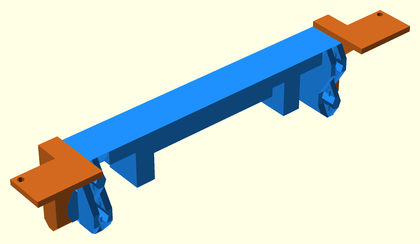
[picture p38: include/snappy-reprap/docs/assembly/y_axis_assembly_2_after.png]
 |  | 

### Step 3

  - Join two XY sled parts together. Make sure the bottom racks line up.

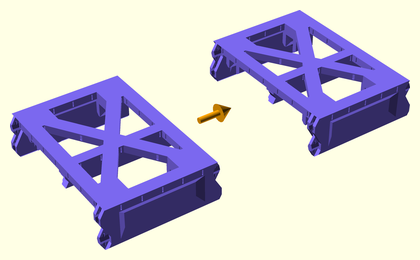
[picture p39: include/snappy-reprap/docs/assembly/y_axis_assembly_3_before.png]
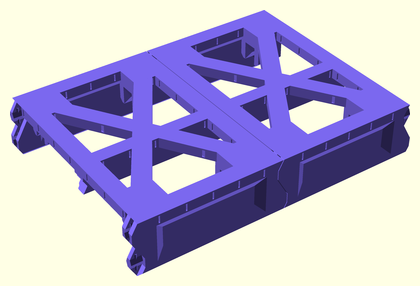
[picture p40: include/snappy-reprap/docs/assembly/y_axis_assembly_3_after.png]
 |  | 

### Step 4

  - Join a Y sled endcap assembly to one end of the Y sled central assembly.

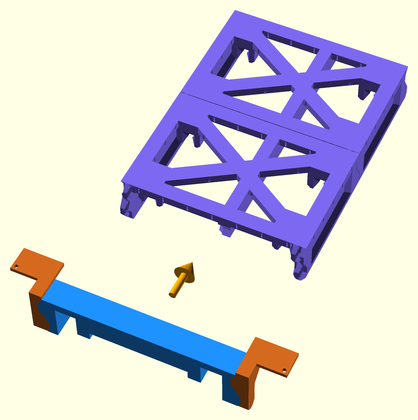
[picture p41: include/snappy-reprap/docs/assembly/y_axis_assembly_4_before.png]
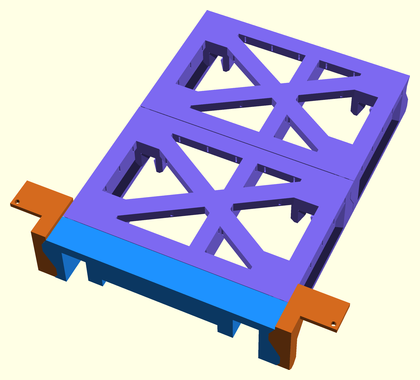
[picture p42: include/snappy-reprap/docs/assembly/y_axis_assembly_4_after.png]
 |  | 

### Step 5

  - Slide the Y sled partial assembly onto the Y axis rails assembly, so that it is centered.

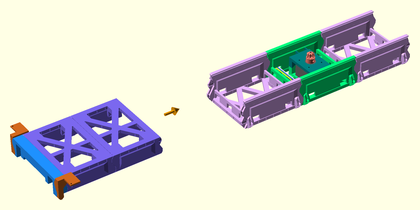
[picture p43: include/snappy-reprap/docs/assembly/y_axis_assembly_5_before.png]
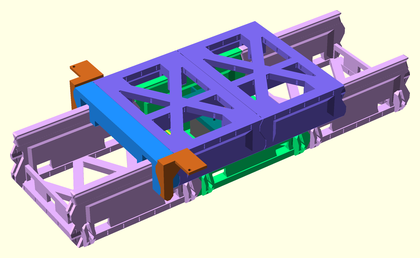
[picture p44: include/snappy-reprap/docs/assembly/y_axis_assembly_5_after.png]
 |  | 

### Step 6

  - Join the other Y sled endcap assembly to the end of the Y sled partial assembly.

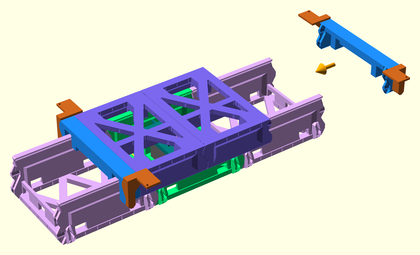
[picture p45: include/snappy-reprap/docs/assembly/y_axis_assembly_6_before.png]
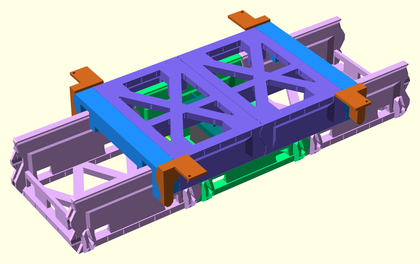
[picture p46: include/snappy-reprap/docs/assembly/y_axis_assembly_6_after.png]
 |  | 

### Step 7

  - Join a rail endcap to each end of the Y axis with completed sled assembly.

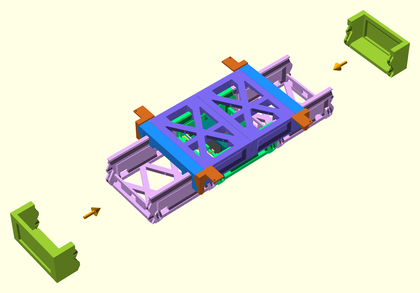
[picture p47: include/snappy-reprap/docs/assembly/y_axis_assembly_7_before.png]
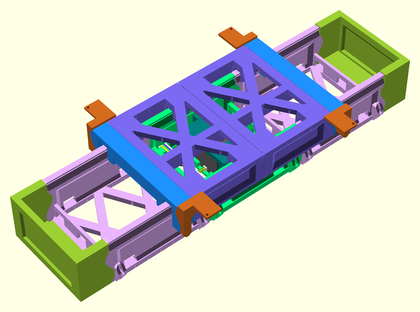
[picture p48: include/snappy-reprap/docs/assembly/y_axis_assembly_7_after.png]
 |  | 

## X Motor Segment Assembly

5. Seat the stepper motor with drive gear in the X/Y motor rail segment. Clamp it into place with a motor mount plate with micro-switch. Route the wiring out one end.

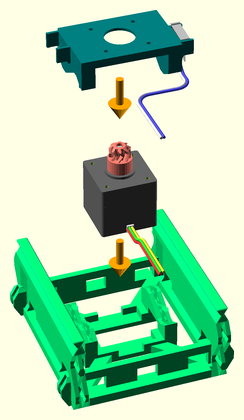
[picture p49: include/snappy-reprap/docs/assembly/x_motor_segment_assembly_before.png]
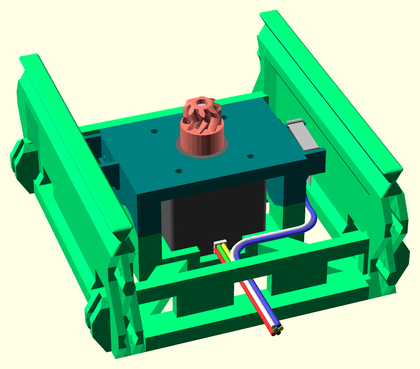
[picture p50: include/snappy-reprap/docs/assembly/x_motor_segment_assembly_after.png]
 |  | 

## X Axis Assembly

### Step 1

  - Join a rail segment to each end of a motor rail assembly, to make the X axis slider. Route the wiring to one end of the slider assembly.

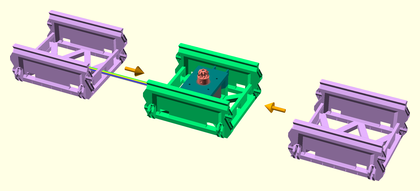
[picture p51: include/snappy-reprap/docs/assembly/x_axis_assembly_1_before.png]
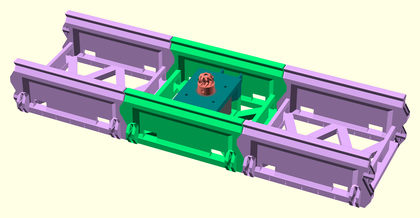
[picture p52: include/snappy-reprap/docs/assembly/x_axis_assembly_1_after.png]
 |  | 

### Step 2

  - Join two XY sled parts together. Make sure the bottom racks line up.

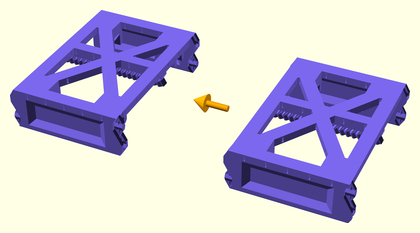
[picture p53: include/snappy-reprap/docs/assembly/x_axis_assembly_2_before.png]
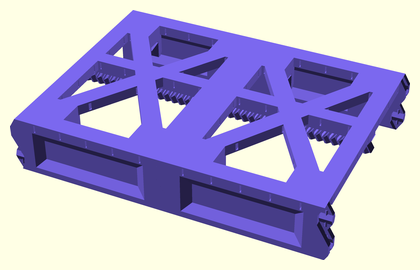
[picture p54: include/snappy-reprap/docs/assembly/x_axis_assembly_2_after.png]
 |  | 

### Step 3

  - Join the X sled cable-chain mount to the front/left side of the X sled endstop.

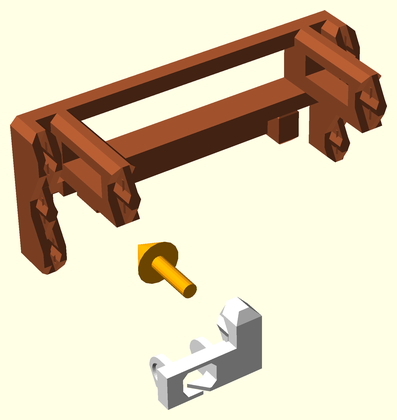
[picture p55: include/snappy-reprap/docs/assembly/x_axis_assembly_3_before.png]
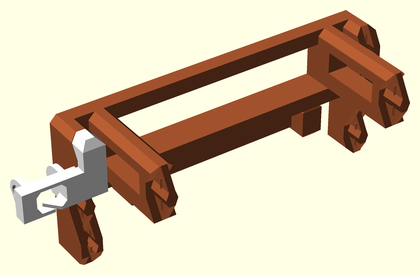
[picture p56: include/snappy-reprap/docs/assembly/x_axis_assembly_3_after.png]
 |  | 

### Step 4

  - Join an X sled endcap assembly to one end of the X sled central assembly.

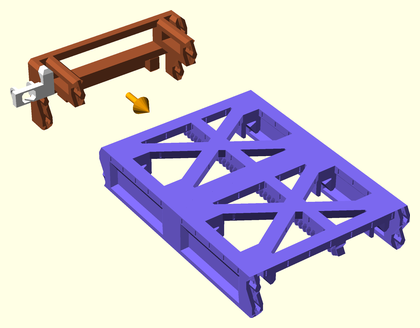
[picture p57: include/snappy-reprap/docs/assembly/x_axis_assembly_4_before.png]
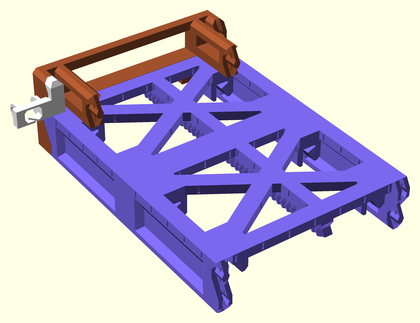
[picture p58: include/snappy-reprap/docs/assembly/x_axis_assembly_4_after.png]
 |  | 

### Step 5

  - Slide the X sled partial assembly onto the X axis rails assembly, so that it is centered.

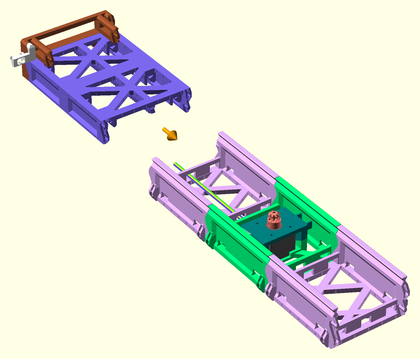
[picture p59: include/snappy-reprap/docs/assembly/x_axis_assembly_5_before.png]
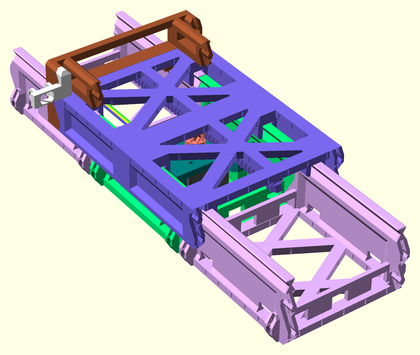
[picture p60: include/snappy-reprap/docs/assembly/x_axis_assembly_5_after.png]
 |  | 

### Step 6

  - Connect the Y axis assembly to the XY joiner on the X axis partial assembly. Route the Y axis wiring through the front hole in the XY joiner.

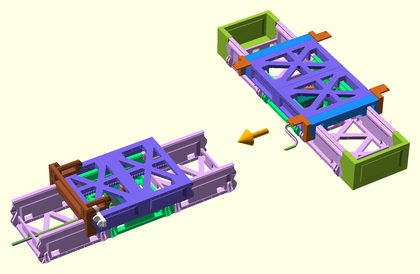
[picture p61: include/snappy-reprap/docs/assembly/x_axis_assembly_6_before.png]
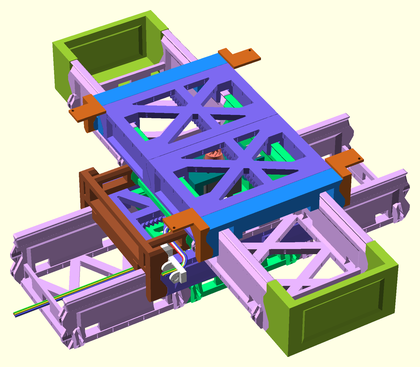
[picture p62: include/snappy-reprap/docs/assembly/x_axis_assembly_6_after.png]
 |  | 

### Step 7

  - Join the other X sled endcap assembly to the end of the X sled assembly, fixing the Y sled assembly in place.

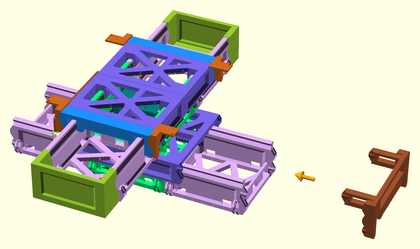
[picture p63: include/snappy-reprap/docs/assembly/x_axis_assembly_7_before.png]
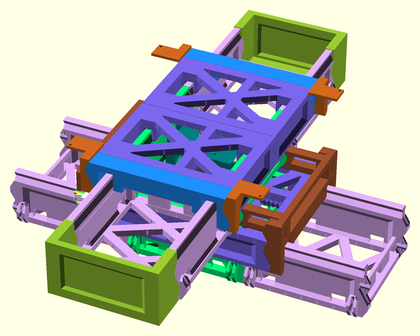
[picture p64: include/snappy-reprap/docs/assembly/x_axis_assembly_7_after.png]
 |  | 

### Step 8

  - Attach the cable chain joiner mount to the X motor segment, on the same side as the X sled cable chain joiner and Y axis wiring.

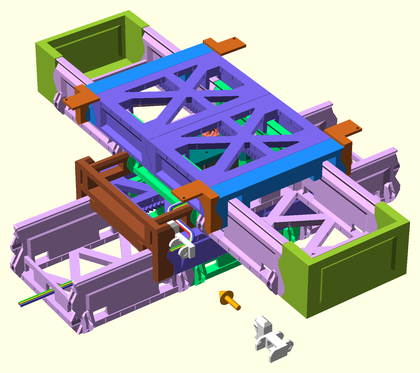
[picture p65: include/snappy-reprap/docs/assembly/x_axis_assembly_8_before.png]
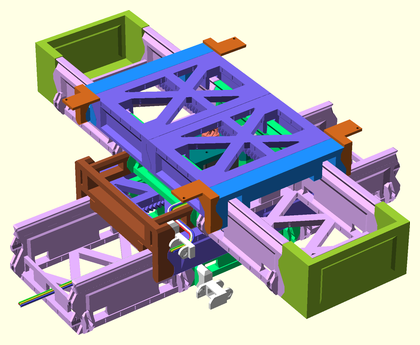
[picture p66: include/snappy-reprap/docs/assembly/x_axis_assembly_8_after.png]
 |  | 

### Step 9

  - Attach the cable-chain assembly (with 13 or 14 links) to the cable chain mounts on the X axis assembly, making sure to feed the Y-axis wiring through the cable chain. Route the wiring in through the wiring access hole beside the cable chain mount, then out through the end of the X axis assembly.

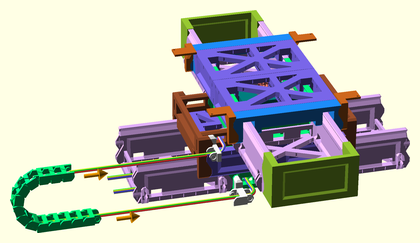
[picture p67: include/snappy-reprap/docs/assembly/x_axis_assembly_9_before.png]
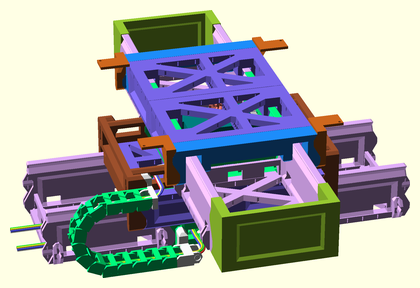
[picture p68: include/snappy-reprap/docs/assembly/x_axis_assembly_9_after.png]
 |  | 

## Z Tower Assembly

### Step 1

  - Seat the stepper motor in the Z motor rail segment. Clamp it into place with a motor mount plate without micro-switch. Route the motor wiring out the bottom of the rail.

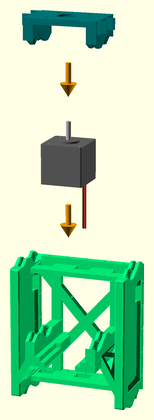
[picture p69: include/snappy-reprap/docs/assembly/z_tower_assembly_1_before.png]
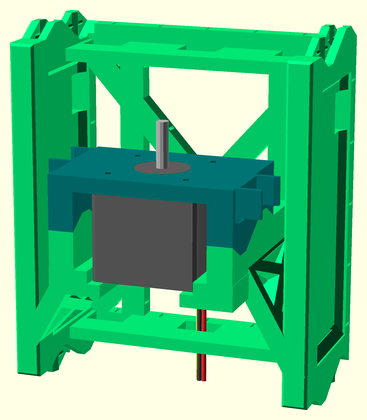
[picture p70: include/snappy-reprap/docs/assembly/z_tower_assembly_1_after.png]
 |  | 

### Step 2

  - Screw the lock nut onto the threaded rod.

 |  | 

### Step 3

  - Screw the rod into the coupler fully, then tighten the lock nut up against the coupler.

 |  | 

### Step 4

  - Press-fit the lifter rod assembly to the mounted motor shaft. Make sure the flatted side of the shaft is aligned with the flat of the shaft hole.

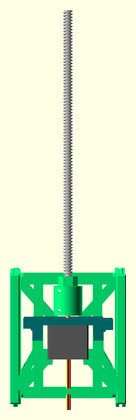
[picture p71: include/snappy-reprap/docs/assembly/z_tower_assembly_4_after.png]
 |  | 

### Step 5

  - Attach two rail segments to the top of the motor Z lifter assembly.

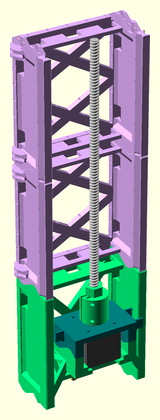
[picture p72: include/snappy-reprap/docs/assembly/z_tower_assembly_5_after.png]
 |  | 

### Step 6

  - Attach support legs to each side of the yz_joiner part.

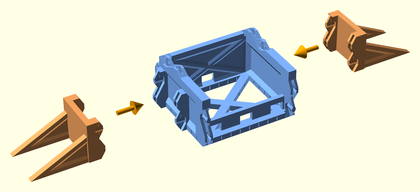
[picture p73: include/snappy-reprap/docs/assembly/z_tower_assembly_6_before.png]
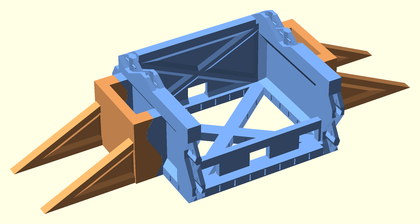
[picture p74: include/snappy-reprap/docs/assembly/z_tower_assembly_6_after.png]
 |  | 

## Left Z Tower Assembly

### Step 1

  - Attach the Z rail assembly to the top of a YZ joiner assembly. Route the wires through the back of the YZ joiner.

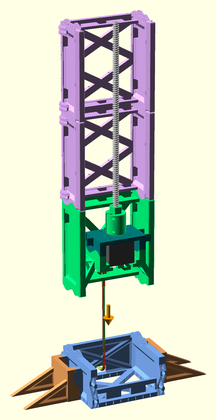
[picture p75: include/snappy-reprap/docs/assembly/left_z_tower_assembly_1_before.png]
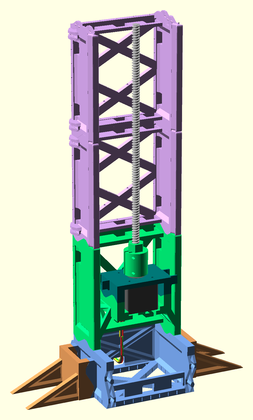
[picture p76: include/snappy-reprap/docs/assembly/left_z_tower_assembly_1_after.png]
 |  | 

### Step 2

  - Attach a cable chain joiner mount to the front-size of the left Z tower, above the top hole of the bottom rail segment.

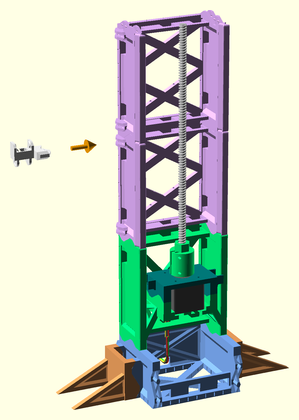
[picture p77: include/snappy-reprap/docs/assembly/left_z_tower_assembly_2_before.png]
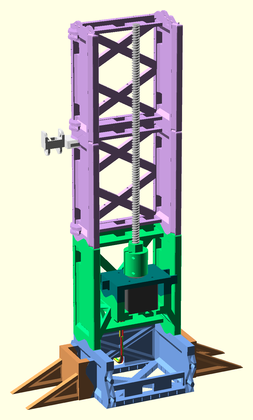
[picture p78: include/snappy-reprap/docs/assembly/left_z_tower_assembly_2_after.png]
 |  | 

## Right Z Tower Assembly

9. Attach the Z rail assembly to the top of the YZ joiner assembly. Route the wires through the front of the YZ joiner.

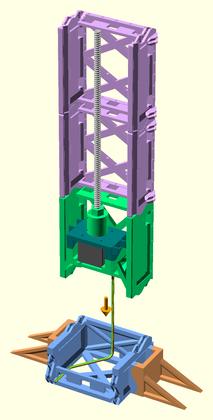
[picture p79: include/snappy-reprap/docs/assembly/right_z_tower_assembly_before.png]
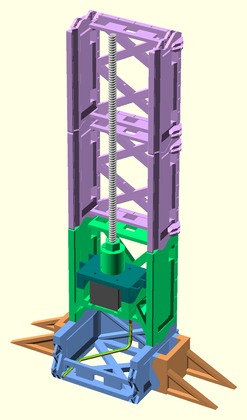
[picture p80: include/snappy-reprap/docs/assembly/right_z_tower_assembly_after.png]
 |  | 

## Extruder Bridge Assembly

### Step 1

  - Insert the 686 bearing into the extruder idler arm.

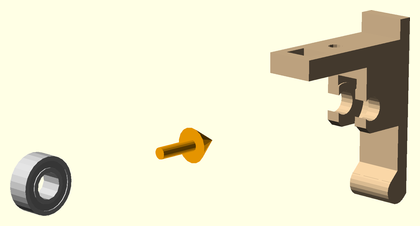
[picture p81: include/snappy-reprap/docs/assembly/extruder_bridge_assembly_1_before.png]
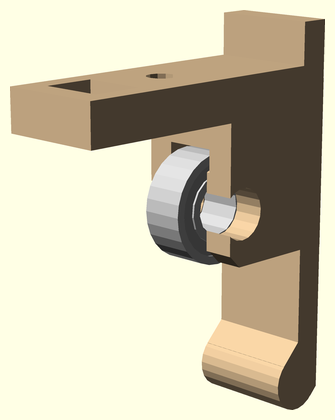
[picture p82: include/snappy-reprap/docs/assembly/extruder_bridge_assembly_1_after.png]
 |  | 

### Step 2

  - Insert the idler axle through the 686 bearing, and lock it into the extruder idler arm with the axle cap.

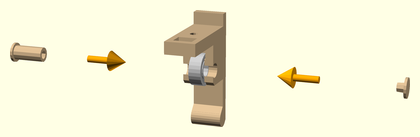
[picture p83: include/snappy-reprap/docs/assembly/extruder_bridge_assembly_2_before.png]
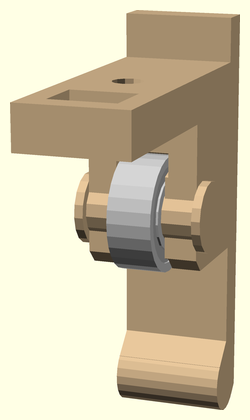
[picture p84: include/snappy-reprap/docs/assembly/extruder_bridge_assembly_2_after.png]
 |  | 

### Step 3

  - Attach the extruder drive gear onto the stepper motor shaft.

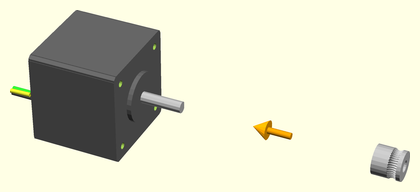
[picture p85: include/snappy-reprap/docs/assembly/extruder_bridge_assembly_3_before.png]
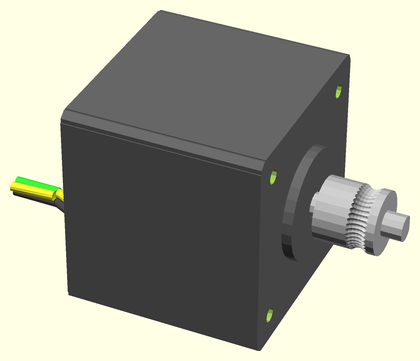
[picture p86: include/snappy-reprap/docs/assembly/extruder_bridge_assembly_3_after.png]
 |  | 

### Step 4

  - Slide the JHead extruder hot end into the slot in the bottom of the JHead platform. Route the wiring up through the wiring access slot, and along the back of the extruder platform.

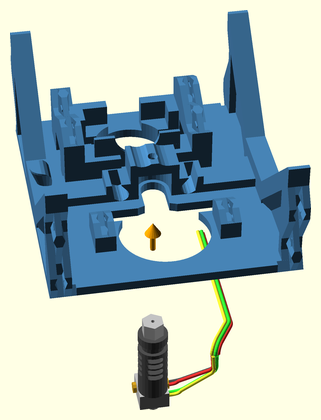
[picture p87: include/snappy-reprap/docs/assembly/extruder_bridge_assembly_4_before.png]
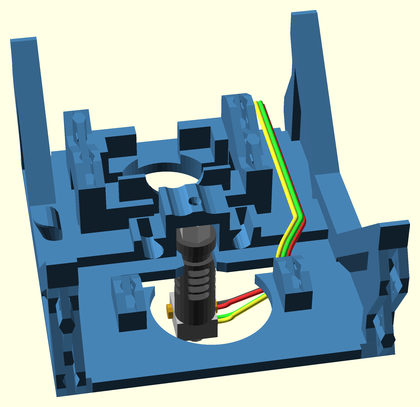
[picture p88: include/snappy-reprap/docs/assembly/extruder_bridge_assembly_4_after.png]
 |  | 

### Step 5

  - Clip the extruder motor with drive gear to the jhead platform using the extruder motor clip.

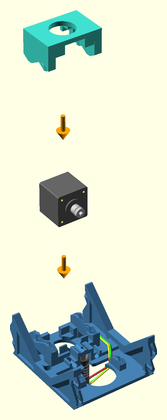
[picture p89: include/snappy-reprap/docs/assembly/extruder_bridge_assembly_5_before.png]
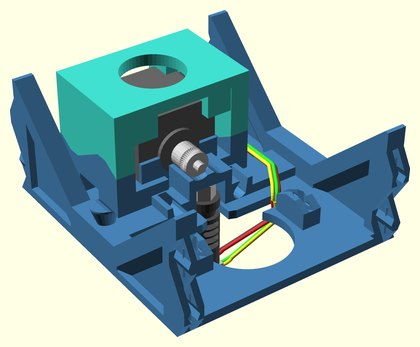
[picture p90: include/snappy-reprap/docs/assembly/extruder_bridge_assembly_5_after.png]
 |  | 

### Step 6

  - Insert the idler arm into the idler hinge hole on the JHead platform.

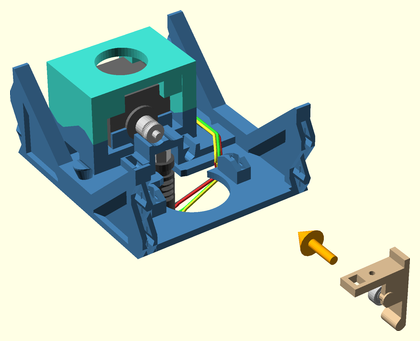
[picture p91: include/snappy-reprap/docs/assembly/extruder_bridge_assembly_6_before.png]
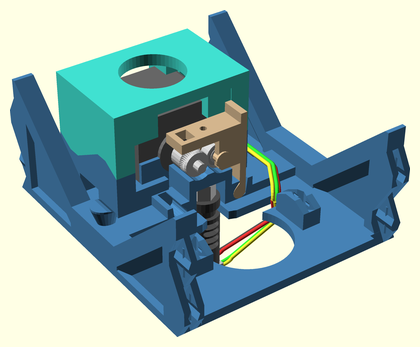
[picture p92: include/snappy-reprap/docs/assembly/extruder_bridge_assembly_6_after.png]
 |  | 

### Step 7

  - Insert the idler latch arm into the latch hinge hole on the JHead platform.

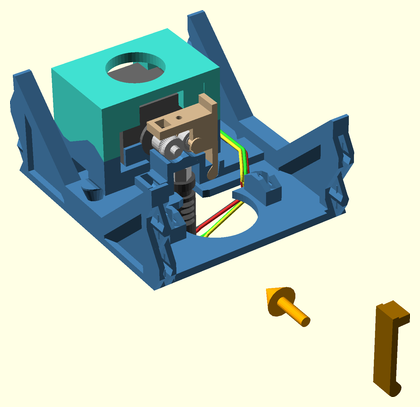
[picture p93: include/snappy-reprap/docs/assembly/extruder_bridge_assembly_7_before.png]
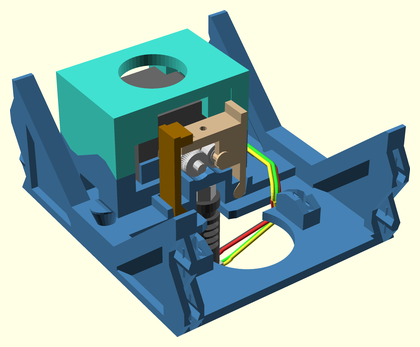
[picture p94: include/snappy-reprap/docs/assembly/extruder_bridge_assembly_7_after.png]
 |  | 

### Step 8

  - Insert the extruder fan shroud into the JHead platform, latching the JHead hot end, and idler and latch arms into place.

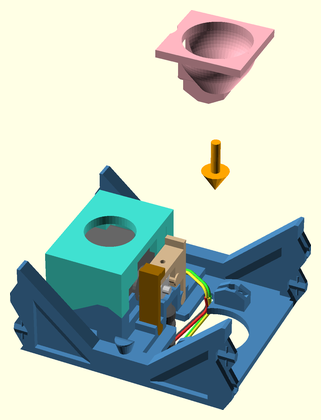
[picture p95: include/snappy-reprap/docs/assembly/extruder_bridge_assembly_8_before.png]
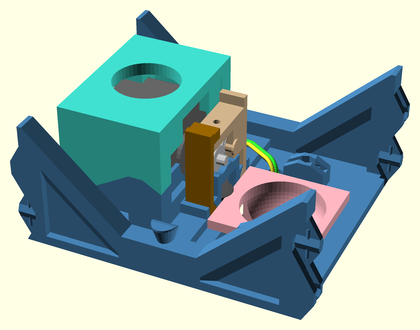
[picture p96: include/snappy-reprap/docs/assembly/extruder_bridge_assembly_8_after.png]
 |  | 

### Step 9

  - Clip a cooling fan to the top of the extruder fan shroud using the extruder fan clip part. Route the wiring along the back side of the extruder platform.

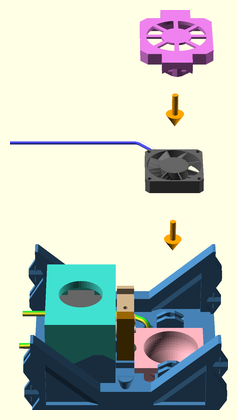
[picture p97: include/snappy-reprap/docs/assembly/extruder_bridge_assembly_9_before.png]
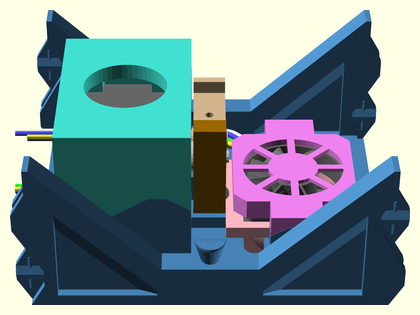
[picture p98: include/snappy-reprap/docs/assembly/extruder_bridge_assembly_9_after.png]
 |  | 

### Step 10

  - Attach a cooling fan to the cooling fan shroud.

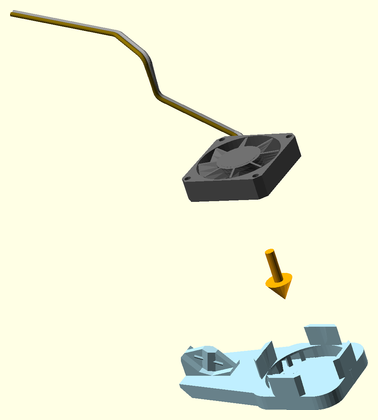
[picture p99: include/snappy-reprap/docs/assembly/extruder_bridge_assembly_10_before.png]
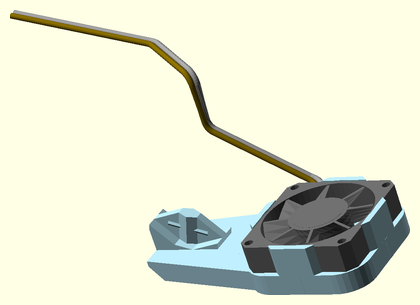
[picture p100: include/snappy-reprap/docs/assembly/extruder_bridge_assembly_10_after.png]
 |  | 

### Step 11

  - Attach the cooling fan shroud assembly to the bottom of the extruder fan shroud. Route the wiring up through the wiring access slot, and along the back side of the extruder platform.

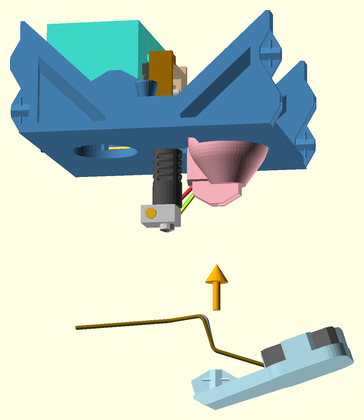
[picture p101: include/snappy-reprap/docs/assembly/extruder_bridge_assembly_11_before.png]
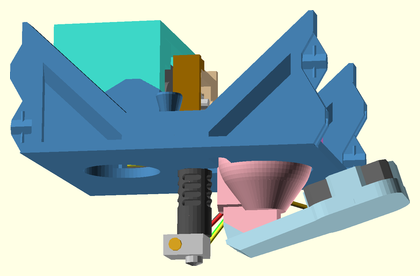
[picture p102: include/snappy-reprap/docs/assembly/extruder_bridge_assembly_11_after.png]
 |  | 

### Step 12

  - Attach rail segments to either end of the extruder platform assembly. Route the wiring through the left side rail segment, and out the front-left wiring access hole.

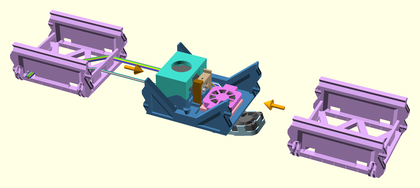
[picture p103: include/snappy-reprap/docs/assembly/extruder_bridge_assembly_12_before.png]
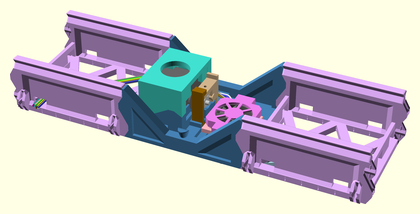
[picture p104: include/snappy-reprap/docs/assembly/extruder_bridge_assembly_12_after.png]
 |  | 

### Step 13

  - Attach a vertical cable-chain mount to the front left side of the extruder bridge.

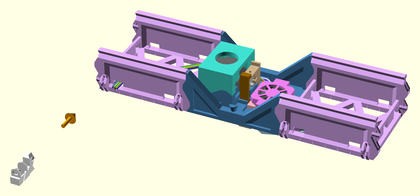
[picture p105: include/snappy-reprap/docs/assembly/extruder_bridge_assembly_13_before.png]
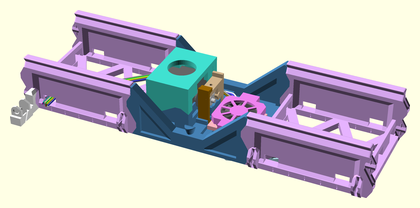
[picture p106: include/snappy-reprap/docs/assembly/extruder_bridge_assembly_13_after.png]
 |  | 

### Step 14

  - Attach Z sled segments to either end of the extruder bridge assembly.

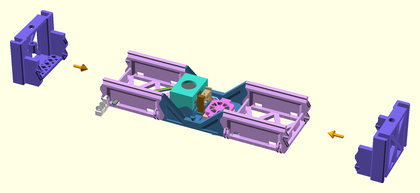
[picture p107: include/snappy-reprap/docs/assembly/extruder_bridge_assembly_14_before.png]
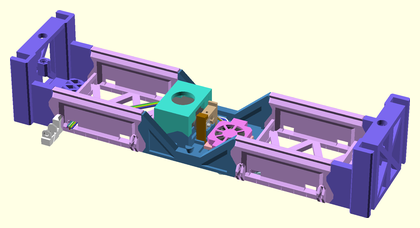
[picture p108: include/snappy-reprap/docs/assembly/extruder_bridge_assembly_14_after.png]
 |  | 

## Final Assembly

### Step 1

  - Attach the right Z tower assembly to the right end of the XY axes assembly. Route the right tower wiring through the rear X axis wiring access holes.

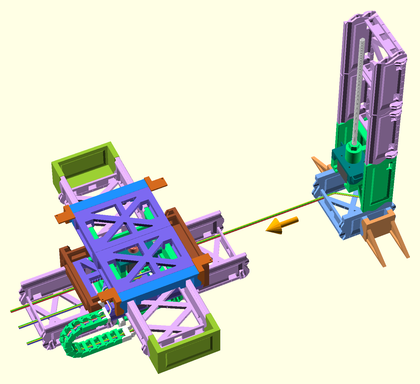
[picture p109: include/snappy-reprap/docs/assembly/final_assembly_1_before.png]
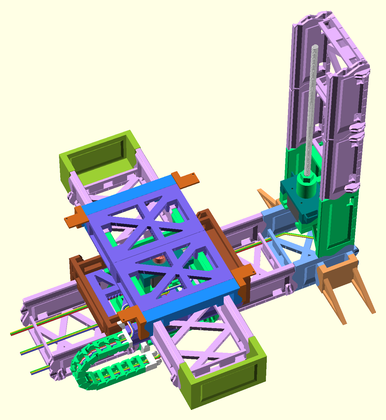
[picture p110: include/snappy-reprap/docs/assembly/final_assembly_1_after.png]
 |  | 

### Step 2

  - Attach the left Z tower assembly to the left end of the XY axes assembly. Route all wiring out the back of the left Z tower base.

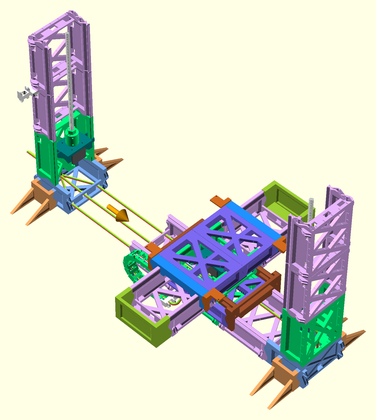
[picture p111: include/snappy-reprap/docs/assembly/final_assembly_2_before.png]
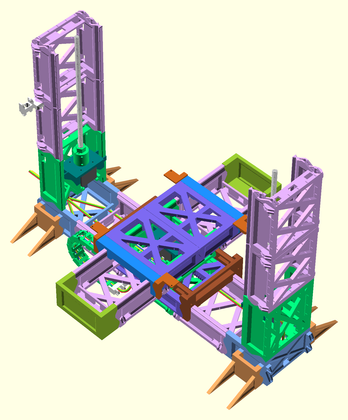
[picture p112: include/snappy-reprap/docs/assembly/final_assembly_2_after.png]
 |  | 

### Step 3

  - Lower the extruder bridge down into the Z tower grooves, screwing the lifter rods into the Z sleds evenly.

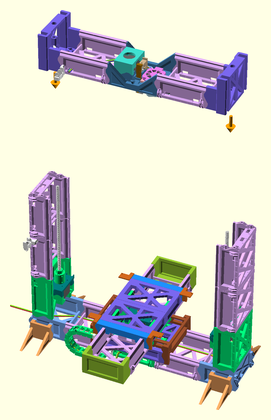
[picture p113: include/snappy-reprap/docs/assembly/final_assembly_3_before.png]
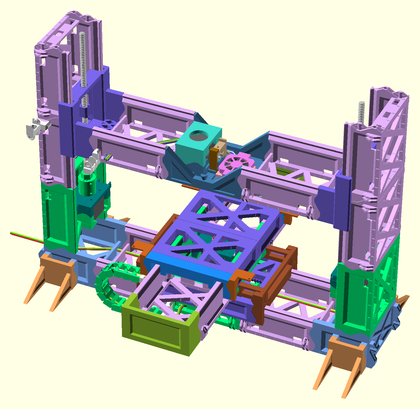
[picture p114: include/snappy-reprap/docs/assembly/final_assembly_3_after.png]
 |  | 

### Step 4

  - Attach a limit microswitch, with wiring, to the Z rail endcap.

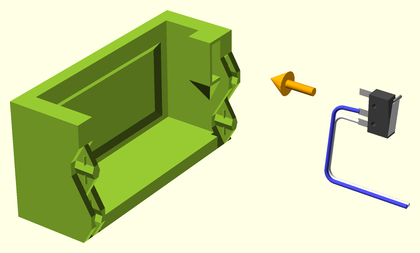
[picture p115: include/snappy-reprap/docs/assembly/final_assembly_4_before.png]
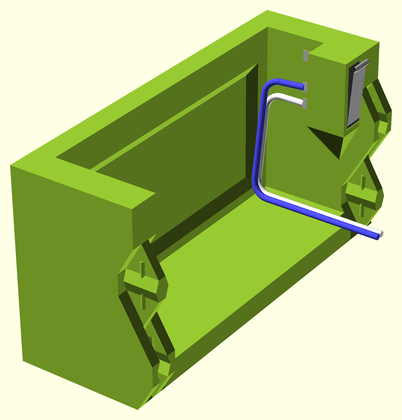
[picture p116: include/snappy-reprap/docs/assembly/final_assembly_4_after.png]
 |  | 

### Step 5

  - Attach the Z tower endcap to the left Z tower. Route the limit switch wiring down through the wiring access holes in the left Z tower, and out the back of the base with the other wiring.

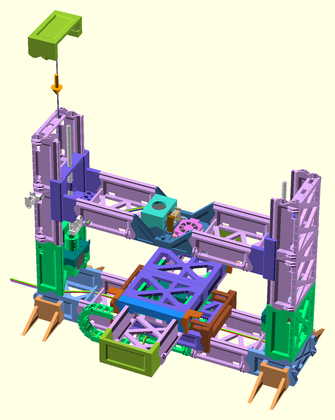
[picture p117: include/snappy-reprap/docs/assembly/final_assembly_5_before.png]
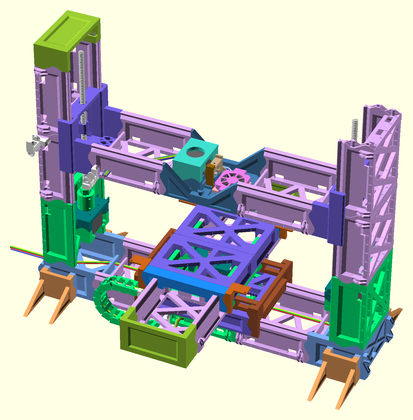
[picture p118: include/snappy-reprap/docs/assembly/final_assembly_5_after.png]
 |  | 

### Step 6

  - Attach a cable chain (17 links) from the extruder bridge cable chain mount to the left Z tower cable chain mount. Route the extruder bridge wiring up through the cable chain, back into the left Z tower through the wiring access hole below the cable chain mount, down the left Z tower, and back out the motor rail segment to where the controller board will be mounted.

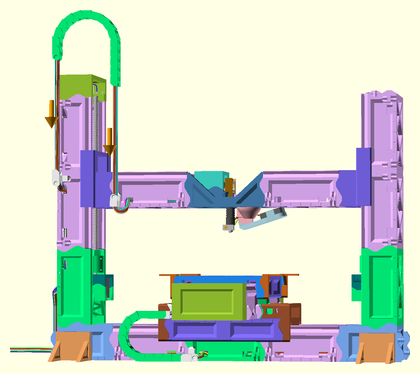
[picture p119: include/snappy-reprap/docs/assembly/final_assembly_6_before.png]
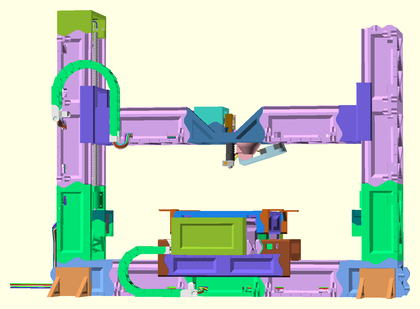
[picture p120: include/snappy-reprap/docs/assembly/final_assembly_6_after.png]
 |  | 

### Step 7

  - Attach the spool holder to the top of the other Z tower.

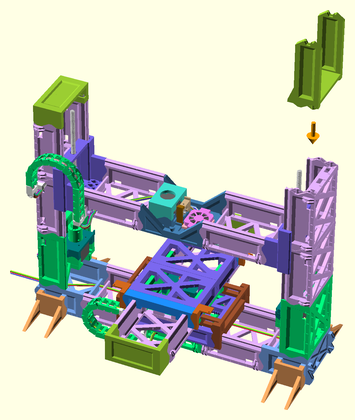
[picture p121: include/snappy-reprap/docs/assembly/final_assembly_7_before.png]
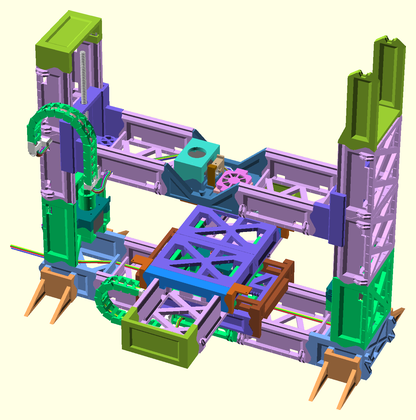
[picture p122: include/snappy-reprap/docs/assembly/final_assembly_7_after.png]
 |  | 

### Step 8

  - Attach the RAMPS motherboard mount to the end of the printer base.

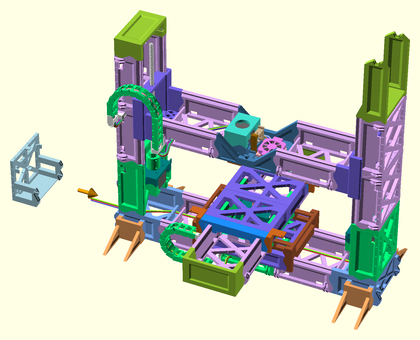
[picture p123: include/snappy-reprap/docs/assembly/final_assembly_8_before.png]
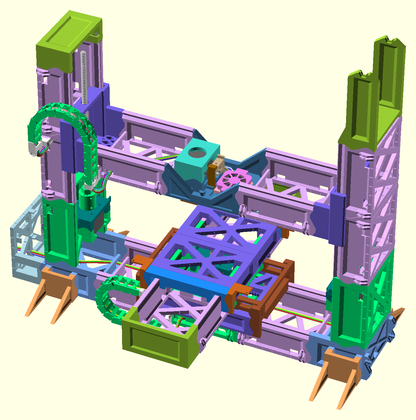
[picture p124: include/snappy-reprap/docs/assembly/final_assembly_8_after.png]
 |  | 

### Step 9

  - Clip the glass build platform to the build platform supports using four binder clips.

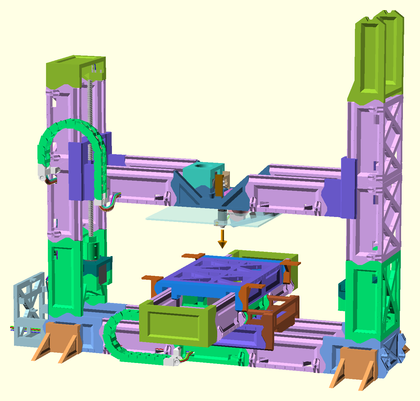
[picture p125: include/snappy-reprap/docs/assembly/final_assembly_9_before.png]
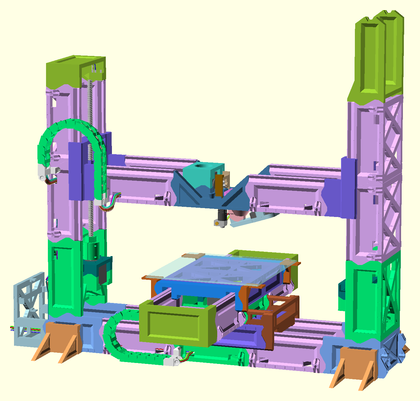
[picture p126: include/snappy-reprap/docs/assembly/final_assembly_9_after.png]
 |  | 

### Step 10

  - Cradle the spool axle in the spool holder top.

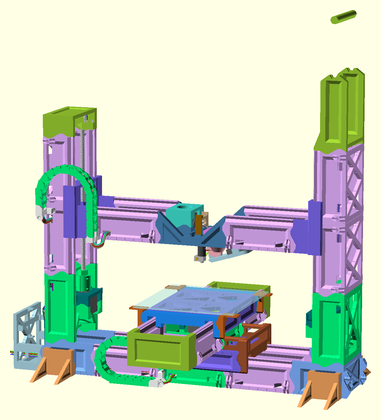
[picture p127: include/snappy-reprap/docs/assembly/final_assembly_10_before.png]
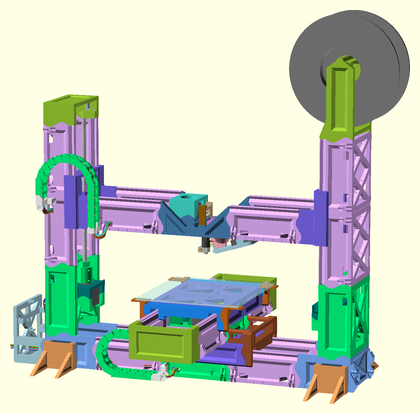
[picture p128: include/snappy-reprap/docs/assembly/final_assembly_10_after.png]
 |  |
