Virindi-AC/Dollo/include/snappy-reprap/docs/assembly/xy_motor_segment_assembly_after.png

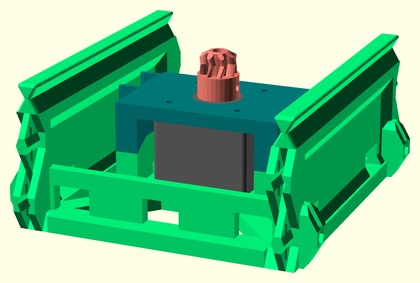
include/snappy-reprap/docs/assembly/xy_motor_segment_assembly_after.png
