Virindi-AC/Dollo/include/snappy-reprap/docs/assembly/z_tower_assembly_7_after.png

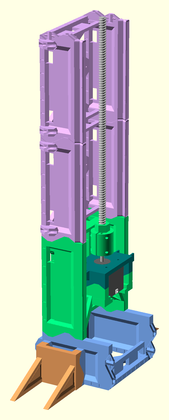
include/snappy-reprap/docs/assembly/z_tower_assembly_7_after.png
