Virindi-AC/Dollo/include/snappy-reprap/docs/assembly/z_tower_assembly_7_before.png

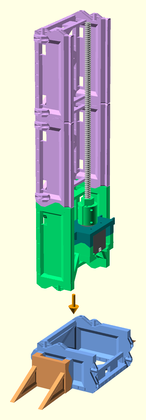
include/snappy-reprap/docs/assembly/z_tower_assembly_7_before.png
