Virindi-AC/Dollo/(commit log)

2016-11-24 First changes. Pinion with set screws, fix motor mount rail height, fix twist corner scalability, add calibration factor to a couple builtin male dovetails.
    [gear.scad, globals.scad, motor_mount_small.scad, rack.scad, twist_corner.scad, x_spacer.scad]
2016-11-24 Add 4-corner for making an under-bed electronics shelf.
    [corner_4.scad]
2016-11-26 New inside ring supports for 3-corner. Needs slic3r support on some of the pin channels.
    [corner.scad, corner_3.scad]
2016-11-28 First untested try at a Dollo carriage with more stuff on it. Not tested yet.
    [ball-bearings.scad, bars.scad, belts.scad, bom.scad, bow_tie.scad, bulldog.scad, cable_strip.scad, cables.scad]
2016-12-03 Reorganize! Part one.
    [Configuration.h, Configuration_adv.h, Marlin Logo.dxf, Menu Plans.xlsx, Old_extention_v2.stl, aitrippers_bowden_mount.scad, aitrippers_bowden_mount.stl, ball-bearings.scad]
2016-12-03 Add Spegelius Z gearing and rack and pinion.
    [GDMUtils.scad, NEMA.scad, acme_screw.scad, cable_chain.scad, cable_chain_link_parts.scad, cable_chain_link_parts.stl, cable_chain_mount_parts.scad, cable_chain_mount_parts.stl]
2016-12-16 V4X movement in progress..
    [bed_carriage.scad, extension.scad, extension_10.scad, extension_250.scad, gears.scad, mockup.scad, motor_mount_small.scad, x_spacer_cut.scad]
2016-12-20 Working on it...
    [mockup.scad, pulley_tooth.scad]
2016-12-28 add extra support to corner side walls
    [corner_3.scad]
